pedrolpena/datapod/schematics/datapod/datapod_front.png

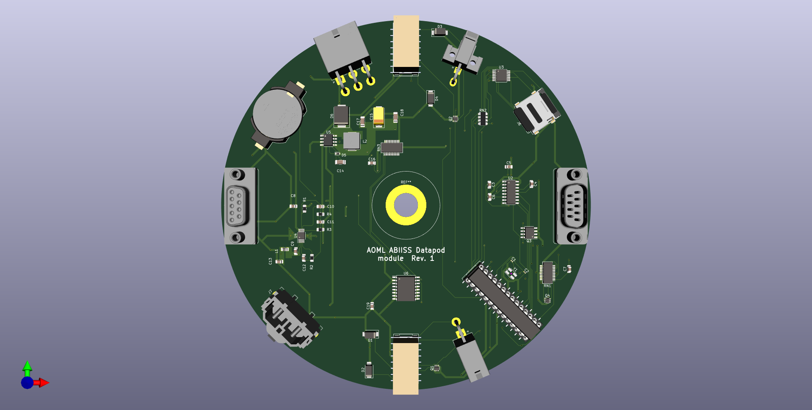
schematics/datapod/datapod_front.png
