pedrolpena/datapod/schematics/datapod/datapod.png

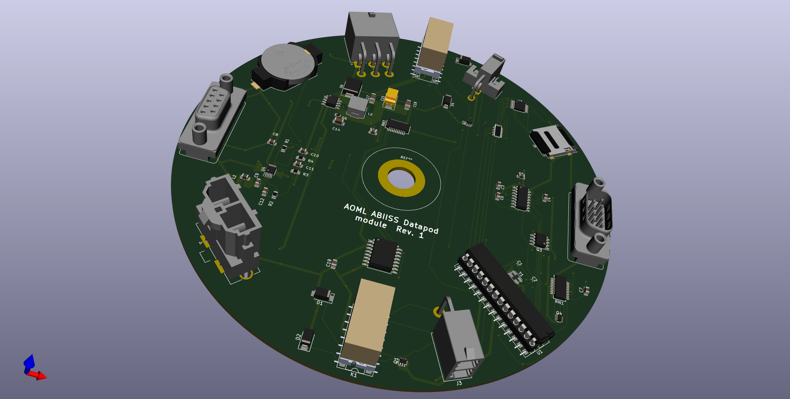
schematics/datapod/datapod.png
