pedrolpena/datapod/schematics/a3la_db25_to_db9/3d_models/db9-male-horizontal.stp

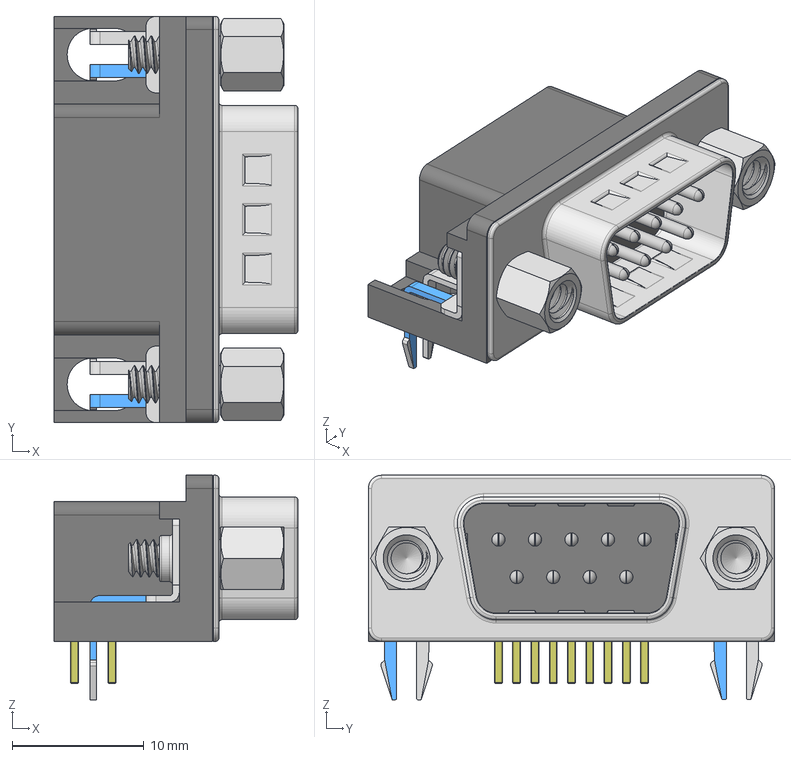
[picture p3: CAD file, 2020-01-16]
schematics/a3la_db25_to_db9/3d_models/db9-male-horizontal.stp
18.5 x 30.8 x 17.0 mm
Тело разъема
Лицевая панель
D-TPIN0 x 9
DIP D-Sub x 2
11,8 х внутренняя резьба x 2
PCB-pin x 5
PCB-pin-7.94 x 4
