pedrolpena/datapod/schematics/a3la_db25_to_db9/3d_models/D-Sub6180xx211821_female.stp

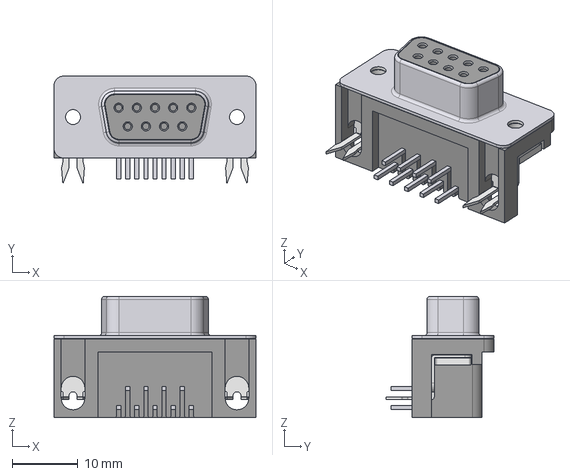
[picture p4: CAD file, 2020-01-16]
schematics/a3la_db25_to_db9/3d_models/D-Sub6180xx211821_female.stp
30.8 x 16.5 x 18.5 mm
