pedrolpena/datapod/schematics/a3la_db25_to_db9/3d_models/Crystal ABM3-16.000MHZ-B2-T.stp

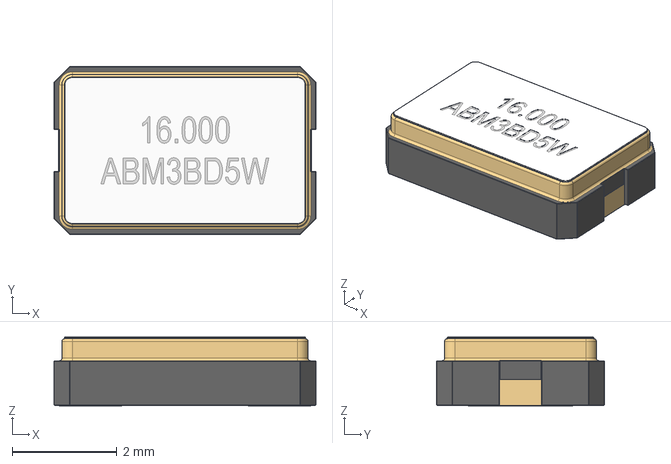
[picture p5: CAD file, 2019-11-07]
schematics/a3la_db25_to_db9/3d_models/Crystal ABM3-16.000MHZ-B2-T.stp
5.00 x 3.20 x 1.31 mm
