pedrolpena/datapod/schematics/a3la_db25_to_db9/3d_models/CR2032-50004LC.stp

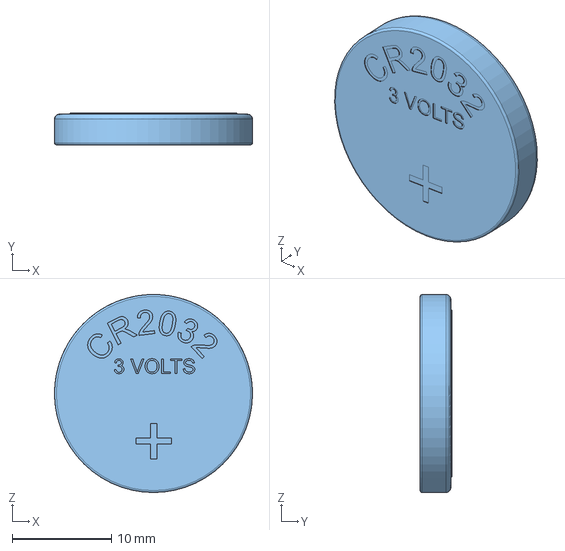
[picture p6: CAD file, 2019-11-07]
schematics/a3la_db25_to_db9/3d_models/CR2032-50004LC.stp
20.0 x 3.20 x 20.0 mm
