pedrolpena/datapod/schematics/a3la_db25_to_db9/3d_models/uSD_card.STEP

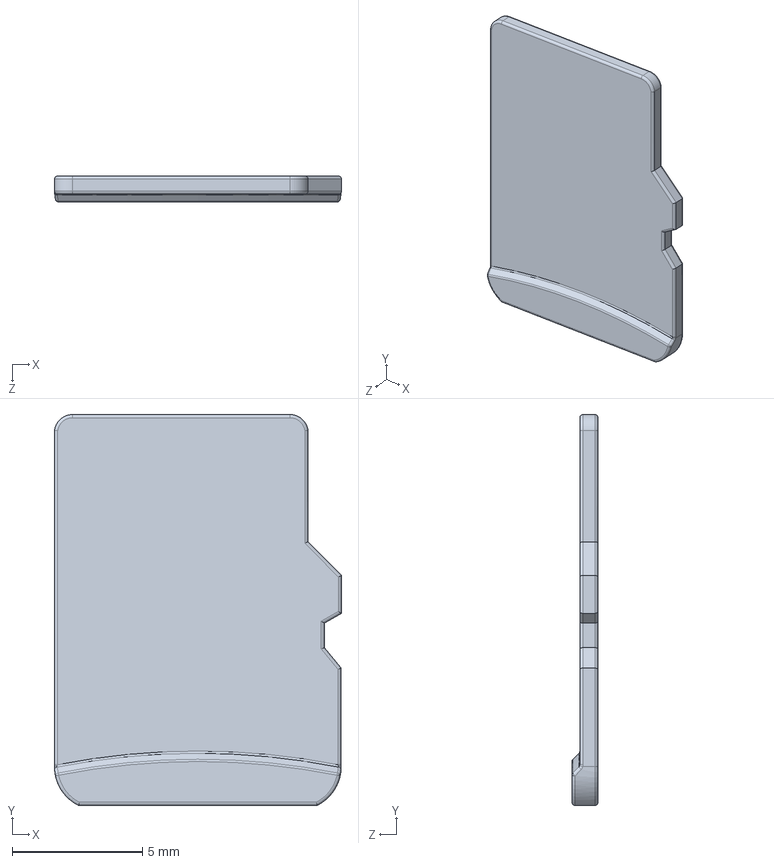
[picture p7: CAD file, 2019-11-07]
schematics/a3la_db25_to_db9/3d_models/uSD_card.STEP
11.0 x 15.0 x 1.00 mm
