pedrolpena/datapod/schematics/a3la_db25_to_db9/3d_models/LD09S24A4GV00LF.stp

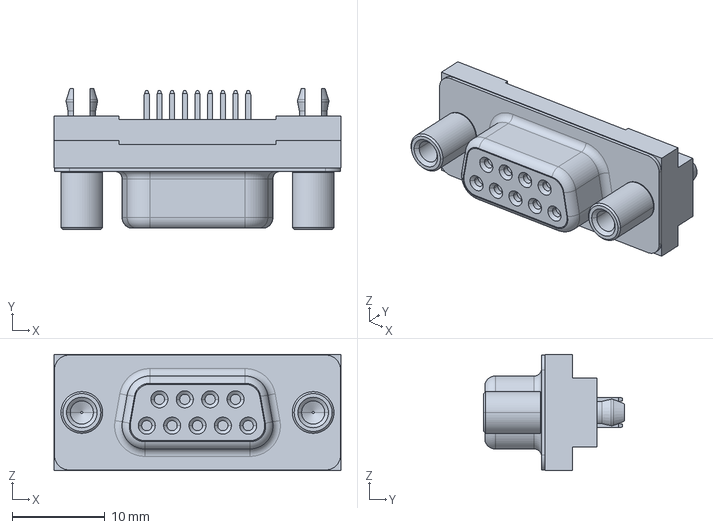
[picture p8: CAD file, 2019-11-06]
schematics/a3la_db25_to_db9/3d_models/LD09S24A4GV00LF.stp
31.0 x 15.2 x 12.6 mm
