pedrolpena/datapod/schematics/a3la_db25_to_db9/3d_models/RELAY_DS2E_L2.step

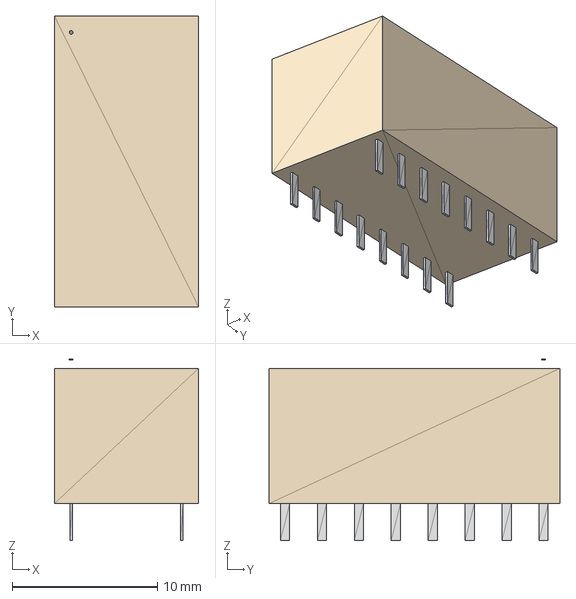
[picture p9: CAD file, 2019-11-06]
schematics/a3la_db25_to_db9/3d_models/RELAY_DS2E_L2.step
9.91 x 20.0 x 12.4 mm
