pedrolpena/datapod/schematics/a3la_db25_to_db9/3d_models/110-xx-328-41-105000.stp

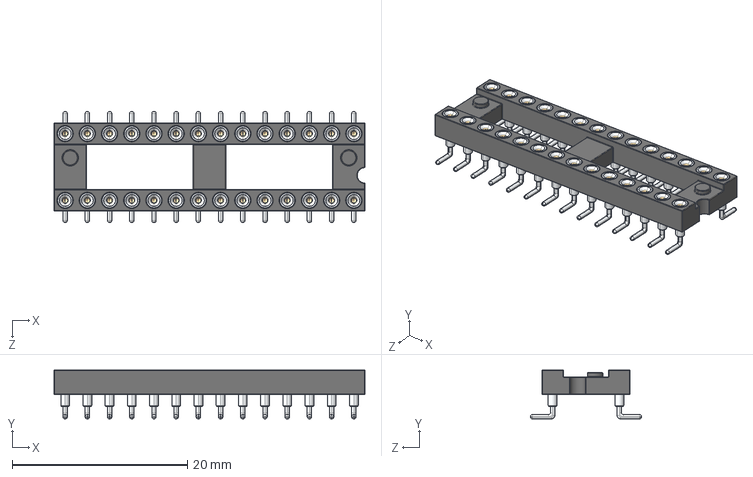
[picture p10: CAD file, 2019-11-06]
schematics/a3la_db25_to_db9/3d_models/110-xx-328-41-105000.stp
35.5 x 5.59 x 12.7 mm
110-xx-328-41-001000
Right-Angle-Pin-SN x 28
