pedrolpena/datapod/schematics/a3la_db25_to_db9/3d_models/SRP6540.stp

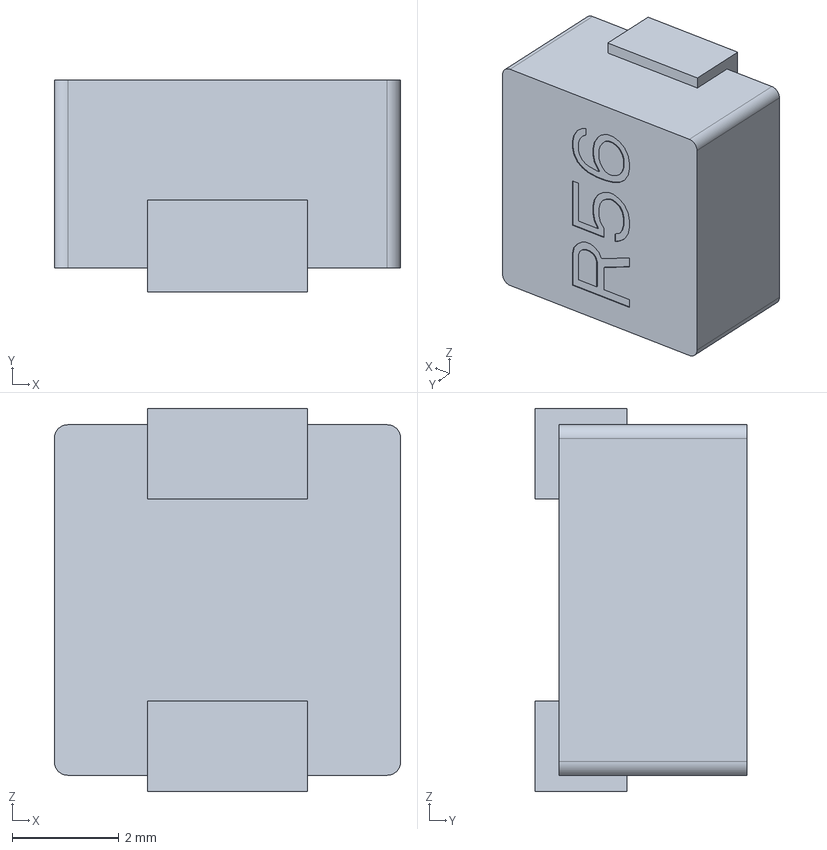
[picture p12: CAD file, 2019-11-06]
schematics/a3la_db25_to_db9/3d_models/SRP6540.stp
6.50 x 3.99 x 7.19 mm
