pedrolpena/datapod/schematics/a3la_db25_to_db9/3d_models/428202213.stp

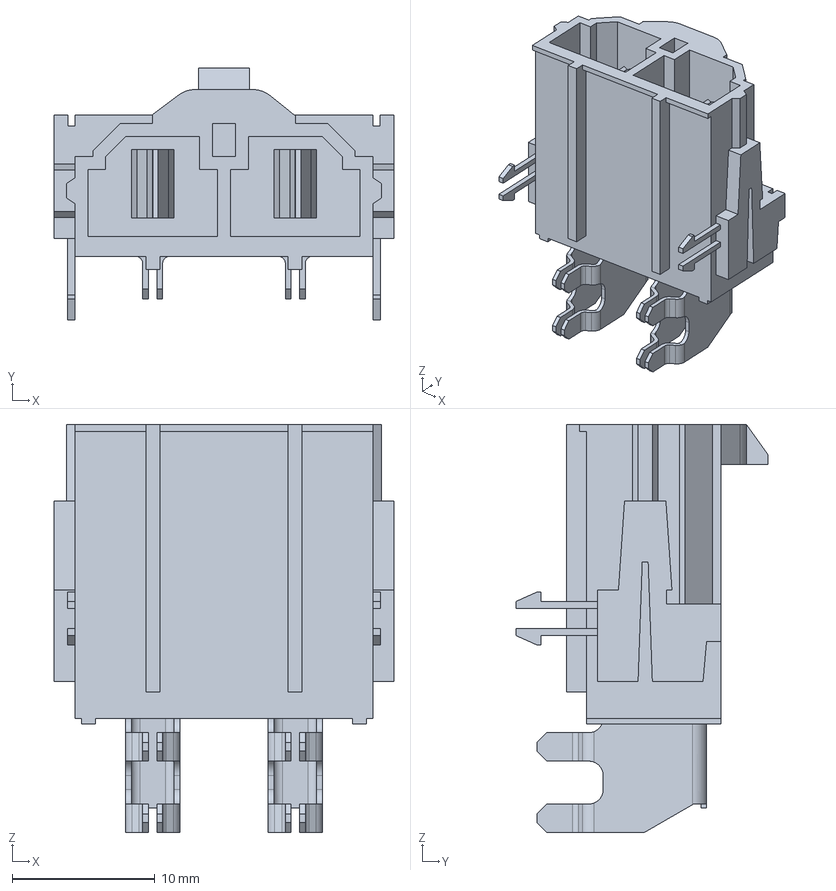
[picture p13: CAD file, 2020-01-16]
schematics/a3la_db25_to_db9/3d_models/428202213.stp
23.8 x 17.6 x 28.6 mm
