pedrolpena/datapod/schematics/a3la_db25_to_db9/3d_models/1053091302.stp

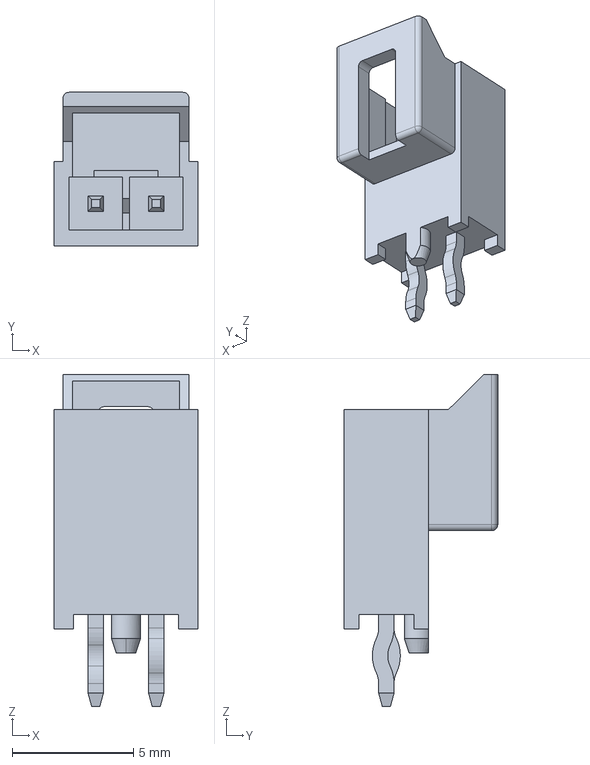
[picture p14: CAD file, 2019-11-18]
schematics/a3la_db25_to_db9/3d_models/1053091302.stp
5.94 x 6.34 x 13.7 mm
