pedrolpena/datapod/schematics/a3la_db25_to_db9/3d_models/039291028.stp

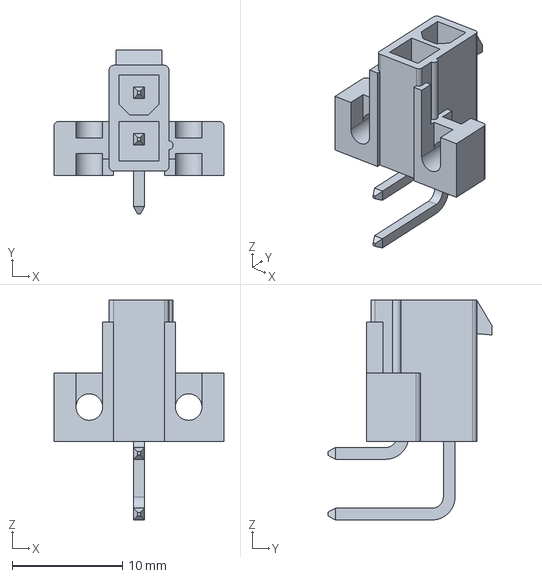
[picture p15: CAD file, 2019-11-06]
schematics/a3la_db25_to_db9/3d_models/039291028.stp
15.4 x 14.9 x 19.9 mm
