pedrolpena/datapod/schematics/a3la_db25_to_db9/3d_models/768250002.stp

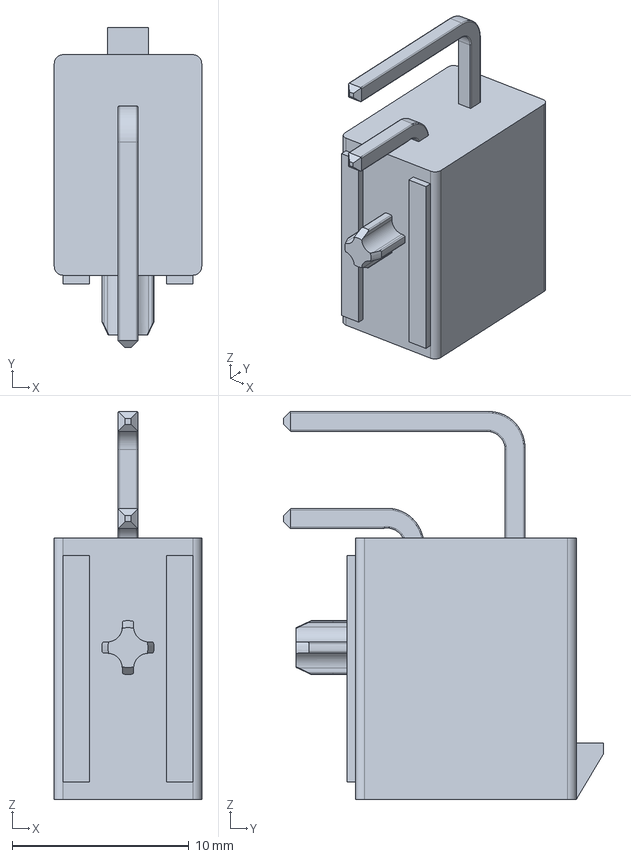
[picture p16: CAD file, 2019-11-06]
schematics/a3la_db25_to_db9/3d_models/768250002.stp
8.35 x 18.1 x 22.0 mm
