pedrolpena/datapod/schematics/a3la_db25_to_db9/3d_models/428192214.stp

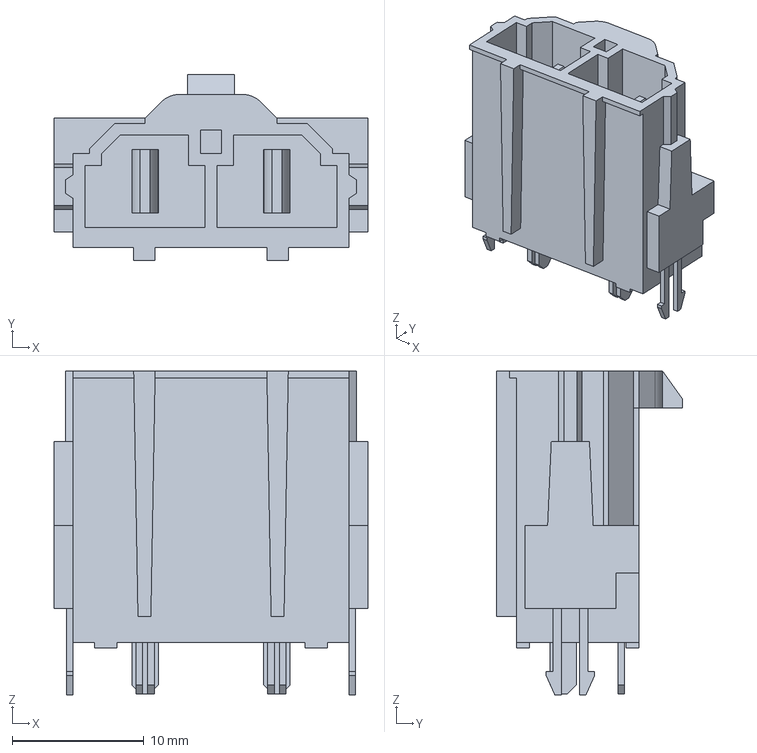
[picture p17: CAD file, 2019-11-06]
schematics/a3la_db25_to_db9/3d_models/428192214.stp
23.8 x 14.1 x 24.6 mm
