pedrolpena/datapod/schematics/a3la_db25_to_db9/3d_models/768250006.stp

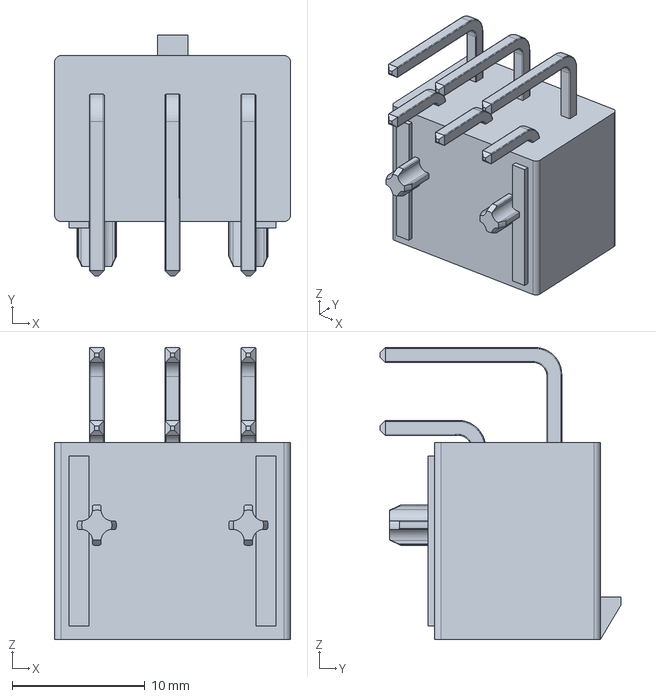
[picture p18: CAD file, 2019-11-06]
schematics/a3la_db25_to_db9/3d_models/768250006.stp
17.8 x 18.1 x 22.0 mm
