pedrolpena/datapod/schematics/a3la_db25_to_db9/3d_models/693072010801.stp

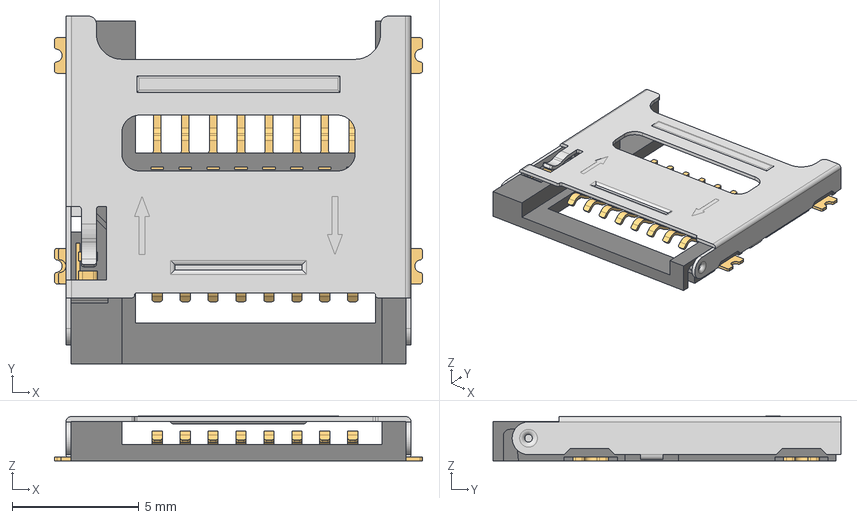
[picture p19: CAD file, 2019-11-06]
schematics/a3la_db25_to_db9/3d_models/693072010801.stp
14.5 x 13.7 x 1.77 mm
693072010801_PIN x 8
693072010801_PATTE x 4
693072010801_CACHE
693072010801_PATTE_SPE
