pedrolpena/datapod/(list of files, cad)

Other CAD files:
schematics/a3la_db25_to_db9/3d_models/LD09P24A4GV00LF .stp
