pedrolpena/datapod/(list of files, drawings)

Other design files:
schematics/datapod/datapod.dsn
schematics/datapod/datapod_last.dsn
