pedrolpena/datapod/schematics/a3la_db25_to_db9/a3la_db25_to_db9.kicad_pcb

## KiCad design schematics/a3la_db25_to_db9/a3la_db25_to_db9.kicad_pcb (2020-02-13)

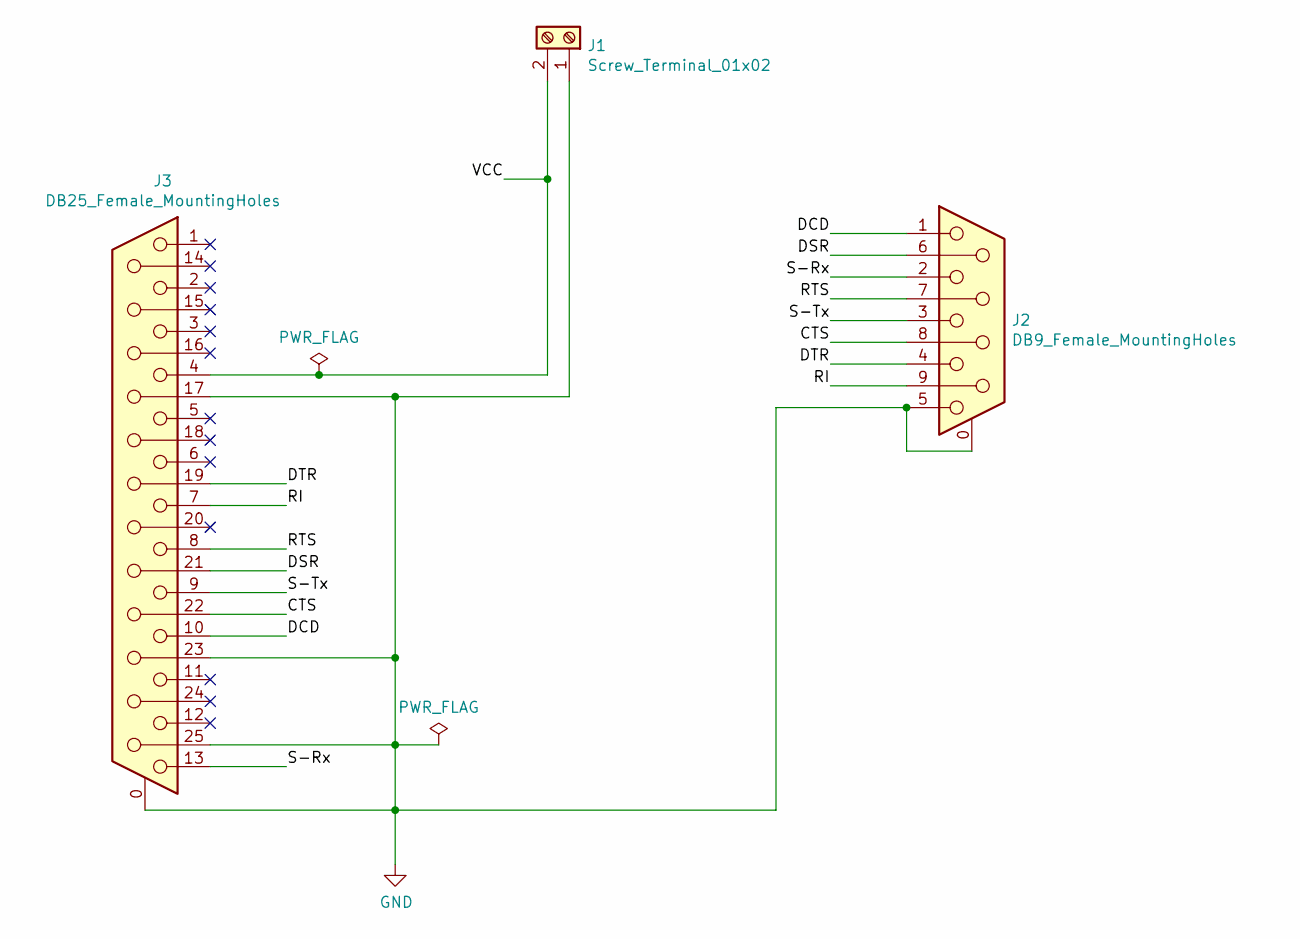
[picture p20: schematic a3la_db25_to_db9.sch, DB25 to DB9 adapter for the NAL A3LA modems]

Parts:
J1: Screw_Terminal_01x02; TerminalBlock_Phoenix_PT-1,5-2-5.0-H_1x02_P5.00mm_Horizontal; part# 277-1667-ND
J2: DB9_Female_MountingHoles; DSUB-9_Female_Horizontal_P2.77x2.84mm_EdgePinOffset7.70mm_H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; Part# A32075-ND
J3: DB25_Female_MountingHoles; DSUB-25_Female_Horizontal_P2.77x2.84mm_EdgePinOffset7.70mm_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; Part# A32077-ND

Connections:
/CTS: J2.8, J3.22
/DCD: J2.1, J3.10
/DSR: J2.6, J3.21
/DTR: J2.4, J3.19
/RI: J2.9, J3.7
/RTS: J2.7, J3.8
/S-Rx: J2.2, J3.13
/S-Tx: J2.3, J3.9
/VCC: J1.2, J3.4
GND: J1.1, J2.0 (PAD), J2.5, J3.0 (PAD), J3.17, J3.23, J3.25

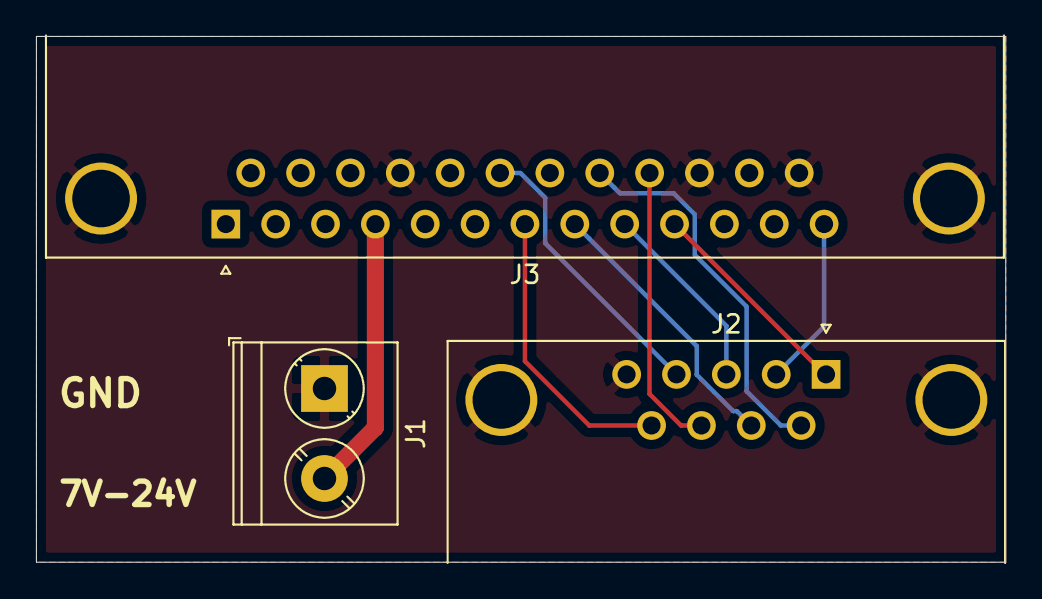
[picture p21: board a3la_db25_to_db9.kicad_pcb from above]

Board: 2 copper layers, 53.8 x 29.2 mm, 3 parts (0 on the bottom side), 10 nets.
