pedrolpena/datapod/schematics/datapod/datapod.kicad_pcb

## KiCad design schematics/datapod/datapod.kicad_pcb (2020-02-05)

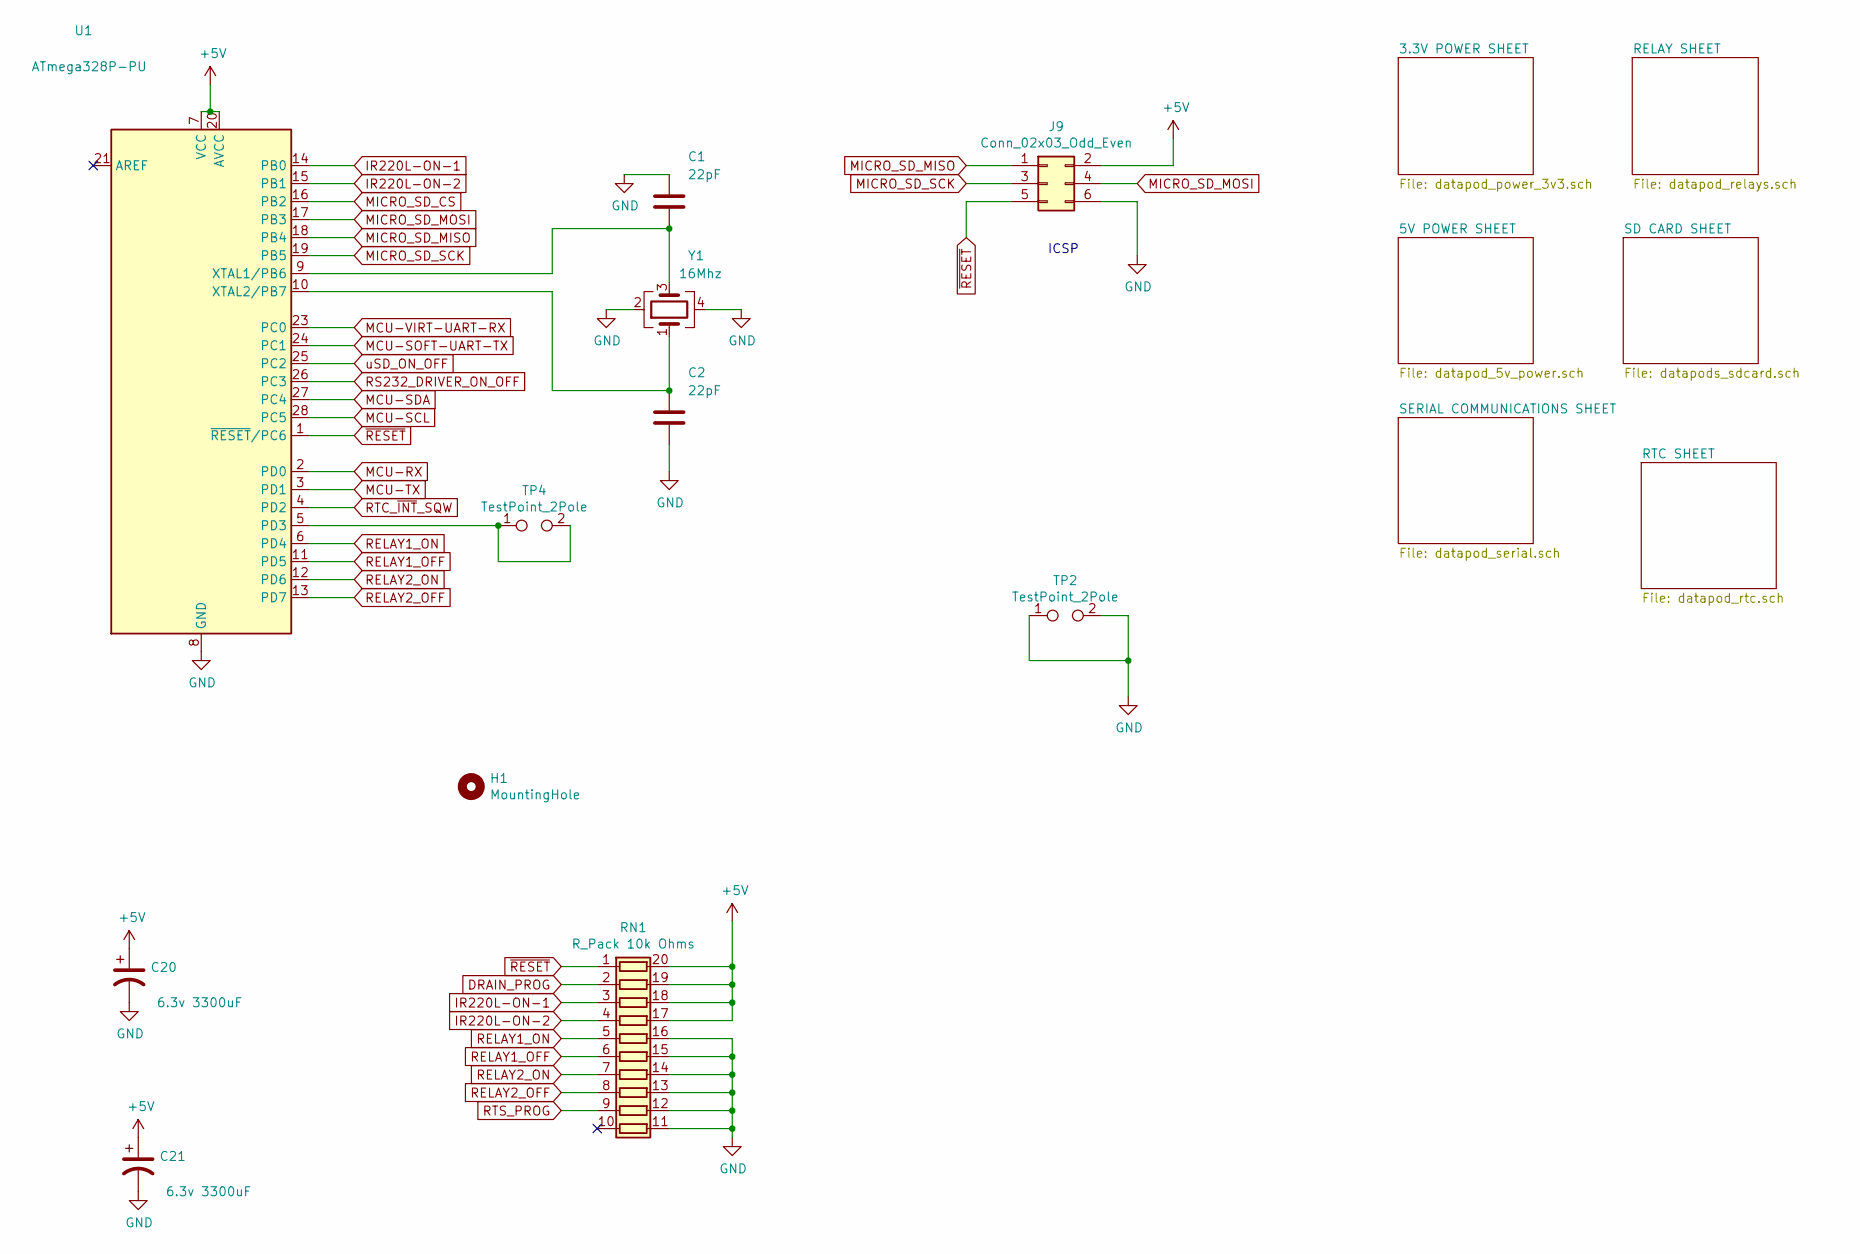
[picture p22: schematic datapod.sch, Datapod data logger and transmitter]

Parts:
C1, C2: 22pF; C_1206_3216Metric_Pad1.42x1.75mm_HandSolder; Part# 399-8165-1-ND
C20, C21: 6.3v 3300uF; CP_Radial_D10.0mm_P5.00mm; Part# 493-1009-ND
H1: MountingHole; MountingHole_0.4_inches_Pad_Via; Part# DNI
J9: Conn_02x03_Odd_Even; PinHeader_2x03_P2.54mm_Vertical_SMD; Part# WM17457-ND
RN1: R_Pack 10k Ohms; SSOP-20_3.9x8.7mm_P0.635mm; Part# OSOPT-10KACT-ND
TP2, TP4: TestPoint_2Pole; TestPoint_2Pads_Pitch5.08mm_Drill1.3mm; Part# DNI
U1: ATmega328P-PU; DIP-28_W7.62mm_SMDSocket_SmallPads; Part# 110-47-328-41-105000
Y1: 16Mhz; Oscillator_SMD_EuroQuartz_XO32-4Pin_3.2x2.5mm_HandSoldering; Part# 732-FA-23816B-C

Connections:
+5V: C20.1, C21.1, J9.2, RN1.17 (R4.2), RN1.18 (R3.2), RN1.19 (R2.2), RN1.20 (R1.2), U1.7 (VCC), U1.20 (AVCC); also elsewhere on the board
DRAIN_PROG: RN1.2 (R2.1); also elsewhere on the board
GND: C1.1, C2.2, C20.2, C21.2, J9.6, RN1.11 (R10.2), RN1.12 (R9.2), RN1.13 (R8.2), RN1.14 (R7.2), RN1.15 (R6.2), RN1.16 (R5.2), TP2.1, TP2.2, U1.8 (GND), U1.22 (GND), Y1.2, Y1.4; also elsewhere on the board
IR220L-ON-1: RN1.3 (R3.1), U1.14 (PB0); also elsewhere on the board
IR220L-ON-2: RN1.4 (R4.1), U1.15 (PB1); also elsewhere on the board
MCU-RX: U1.2 (PD0); also elsewhere on the board
MCU-SCL: U1.28 (PC5); also elsewhere on the board
MCU-SDA: U1.27 (PC4); also elsewhere on the board
MCU-SOFT-UART-TX: U1.24 (PC1); also elsewhere on the board
MCU-TX: U1.3 (PD1); also elsewhere on the board
MCU-VIRT-UART-RX: U1.23 (PC0); also elsewhere on the board
MICRO_SD_CS: U1.16 (PB2); also elsewhere on the board
MICRO_SD_MISO: J9.1, U1.18 (PB4); also elsewhere on the board
MICRO_SD_MOSI: J9.4, U1.17 (PB3); also elsewhere on the board
MICRO_SD_SCK: J9.3, U1.19 (PB5); also elsewhere on the board
unnamed: C1.2, U1.9 (XTAL1/PB6), Y1.3
unnamed: C2.1, U1.10 (XTAL2/PB7), Y1.1
unnamed: TP4.1, TP4.2, U1.5 (PD3)
RELAY1_OFF: RN1.6 (R6.1), U1.11 (PD5); also elsewhere on the board
RELAY1_ON: RN1.5 (R5.1), U1.6 (PD4); also elsewhere on the board
RELAY2_OFF: RN1.8 (R8.1), U1.13 (PD7); also elsewhere on the board
RELAY2_ON: RN1.7 (R7.1), U1.12 (PD6); also elsewhere on the board
RS232_DRIVER_ON_OFF: U1.26 (PC3); also elsewhere on the board
RTC_~INT~_SQW: U1.4 (PD2); also elsewhere on the board
RTS_PROG: RN1.9 (R9.1); also elsewhere on the board
uSD_ON_OFF: U1.25 (PC2); also elsewhere on the board
~RESET: J9.5, RN1.1 (R1.1), U1.1 (~RESET~/PC6); also elsewhere on the board

Notes on the sheet:
ICSP

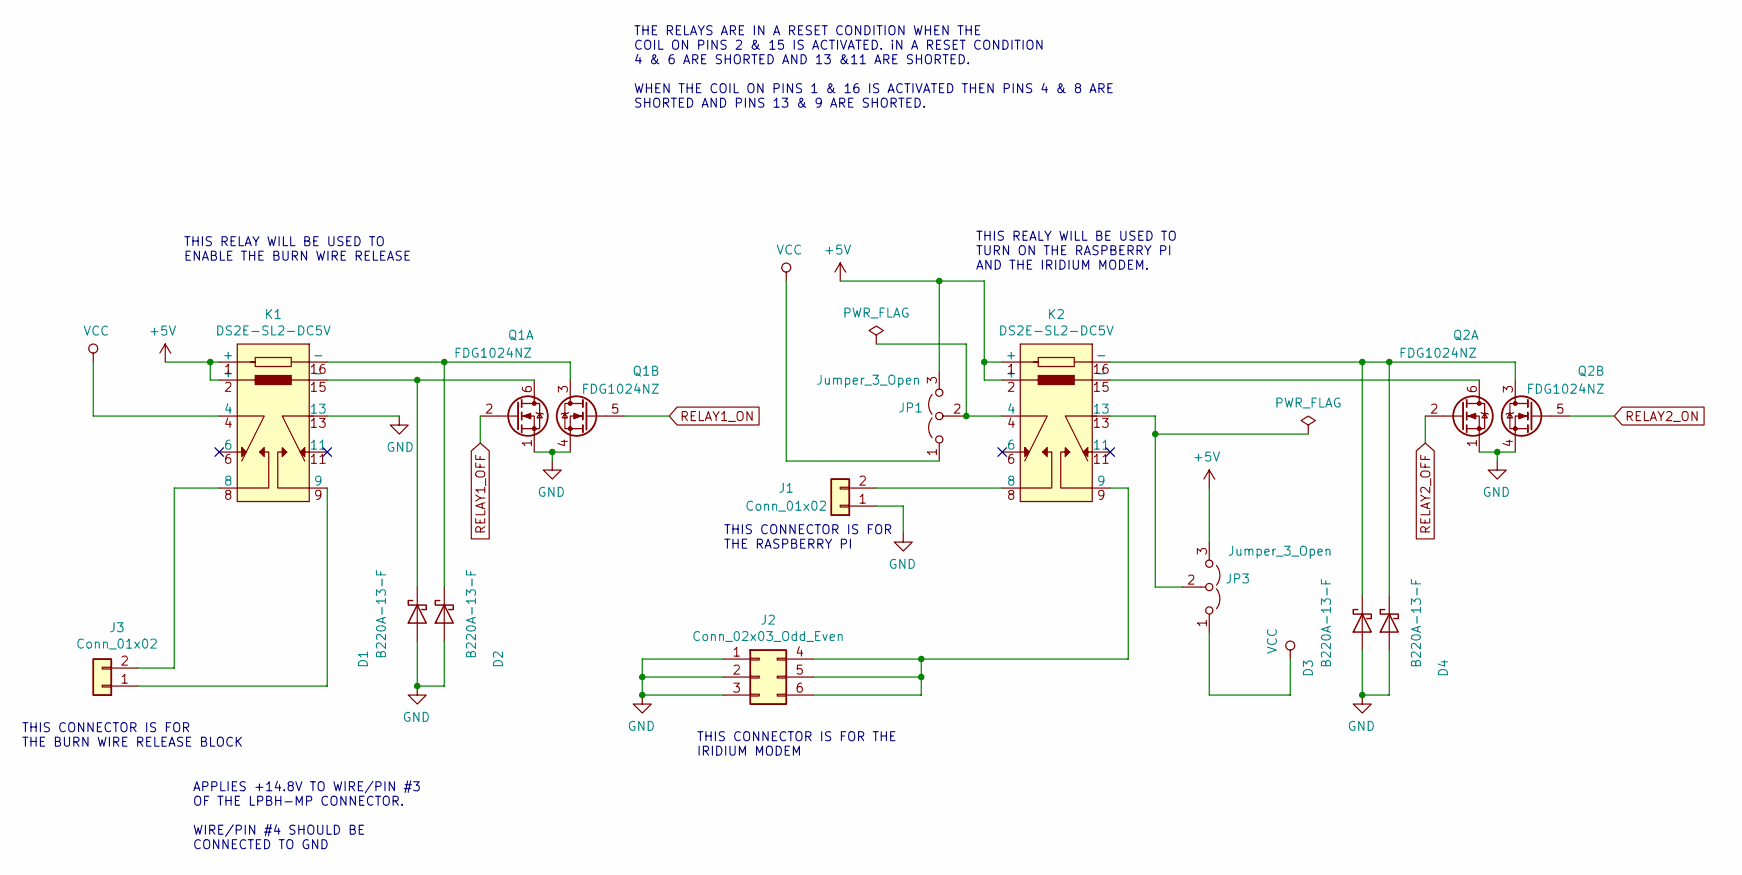
[picture p23: schematic datapod_relays.sch, Relays]

Parts:
D1, D2, D3, D4: B220A-13-F; D_SMA; Part# B220A-FDIDKR-ND
J1: Conn_01x02; Molex_Mini-Fit_Jr_5569-02A1_2x01_P4.20mm_Horizontal; Part# WM3900-ND
J2: Conn_02x03_Odd_Even; Molex_Mega-Fit_76825-0006_2x03_P5.70mm_Horizontal; Part# WM11971-ND
J3: Conn_01x02; Molex_Mega-Fit_76825-0002_2x01_P5.70mm_Horizontal; Part# WM11969-ND
JP1, JP3: Jumper_3_Open; SolderJumper-3_P1.3mm_Open_RoundedPad1.0x1.5mm; Part# DNI
K1, K2: DS2E-SL2-DC5V; DIP-16_W8.89mm_SMDSocket_LongPads; Part# ED11086-ND
Q1, Q2: FDG1024NZ; SOT-363_SC-70-6; Part# FDG1024NZFSCT-ND

Connections:
+5V: JP1.3 (B), JP3.3 (B), K1.1 (+), K1.2 (+), K2.1 (+), K2.2 (+); also elsewhere on the board
GND: D1.2 (A), D2.2 (A), D3.2 (A), D4.2 (A), J1.1, J2.1, J2.2, J2.3, K1.13, Q1.1 (S), Q1.4 (S), Q2.1 (S), Q2.4 (S); also elsewhere on the board
unnamed: D1.1 (K), K1.15 (-), Q1.6 (D)
unnamed: D2.1 (K), K1.16 (-), Q1.3 (D)
unnamed: D3.1 (K), D4.1 (K), K2.16 (-), Q2.3 (D)
unnamed: J1.2, K2.8
unnamed: J2.4, J2.5, J2.6, K2.9
unnamed: J3.1, K1.9
unnamed: J3.2, K1.8
unnamed: JP1.2 (C), K2.4
unnamed: JP3.2 (C), K2.13
unnamed: K2.15 (-), Q2.6 (D)
RELAY1_OFF: Q1.2 (G); also elsewhere on the board
RELAY1_ON: Q1.5 (G); also elsewhere on the board
RELAY2_OFF: Q2.2 (G); also elsewhere on the board
RELAY2_ON: Q2.5 (G); also elsewhere on the board
VCC: JP1.1 (A), JP3.1 (A), K1.4; also elsewhere on the board

Notes on the sheet:
THE RELAYS ARE IN A RESET CONDITION WHEN THE COIL ON PINS 2 & 15 IS ACTIVATED. iN A RESET CONDITION 4 & 6 ARE SHORTED AND 13 &11 ARE SHORTED. WHEN THE COIL ON PINS 1 & 16 IS ACTIVATED THEN PINS 4 & 8 ARE SHORTED AND PINS 13 & 9 ARE SHORTED.
THIS RELAY WILL BE USED TO ENABLE THE BURN WIRE RELEASE
THIS REALY WILL BE USED TO TURN ON THE RASPBERRY PI AND THE IRIDIUM MODEM.
APPLIES +14.8V TO WIRE/PIN #3 OF THE LPBH-MP CONNECTOR. WIRE/PIN #4 SHOULD BE CONNECTED TO GND
THIS CONNECTOR IS FOR THE IRIDIUM MODEM
THIS CONNECTOR IS FOR THE BURN WIRE RELEASE BLOCK
THIS CONNECTOR IS FOR THE RASPBERRY PI

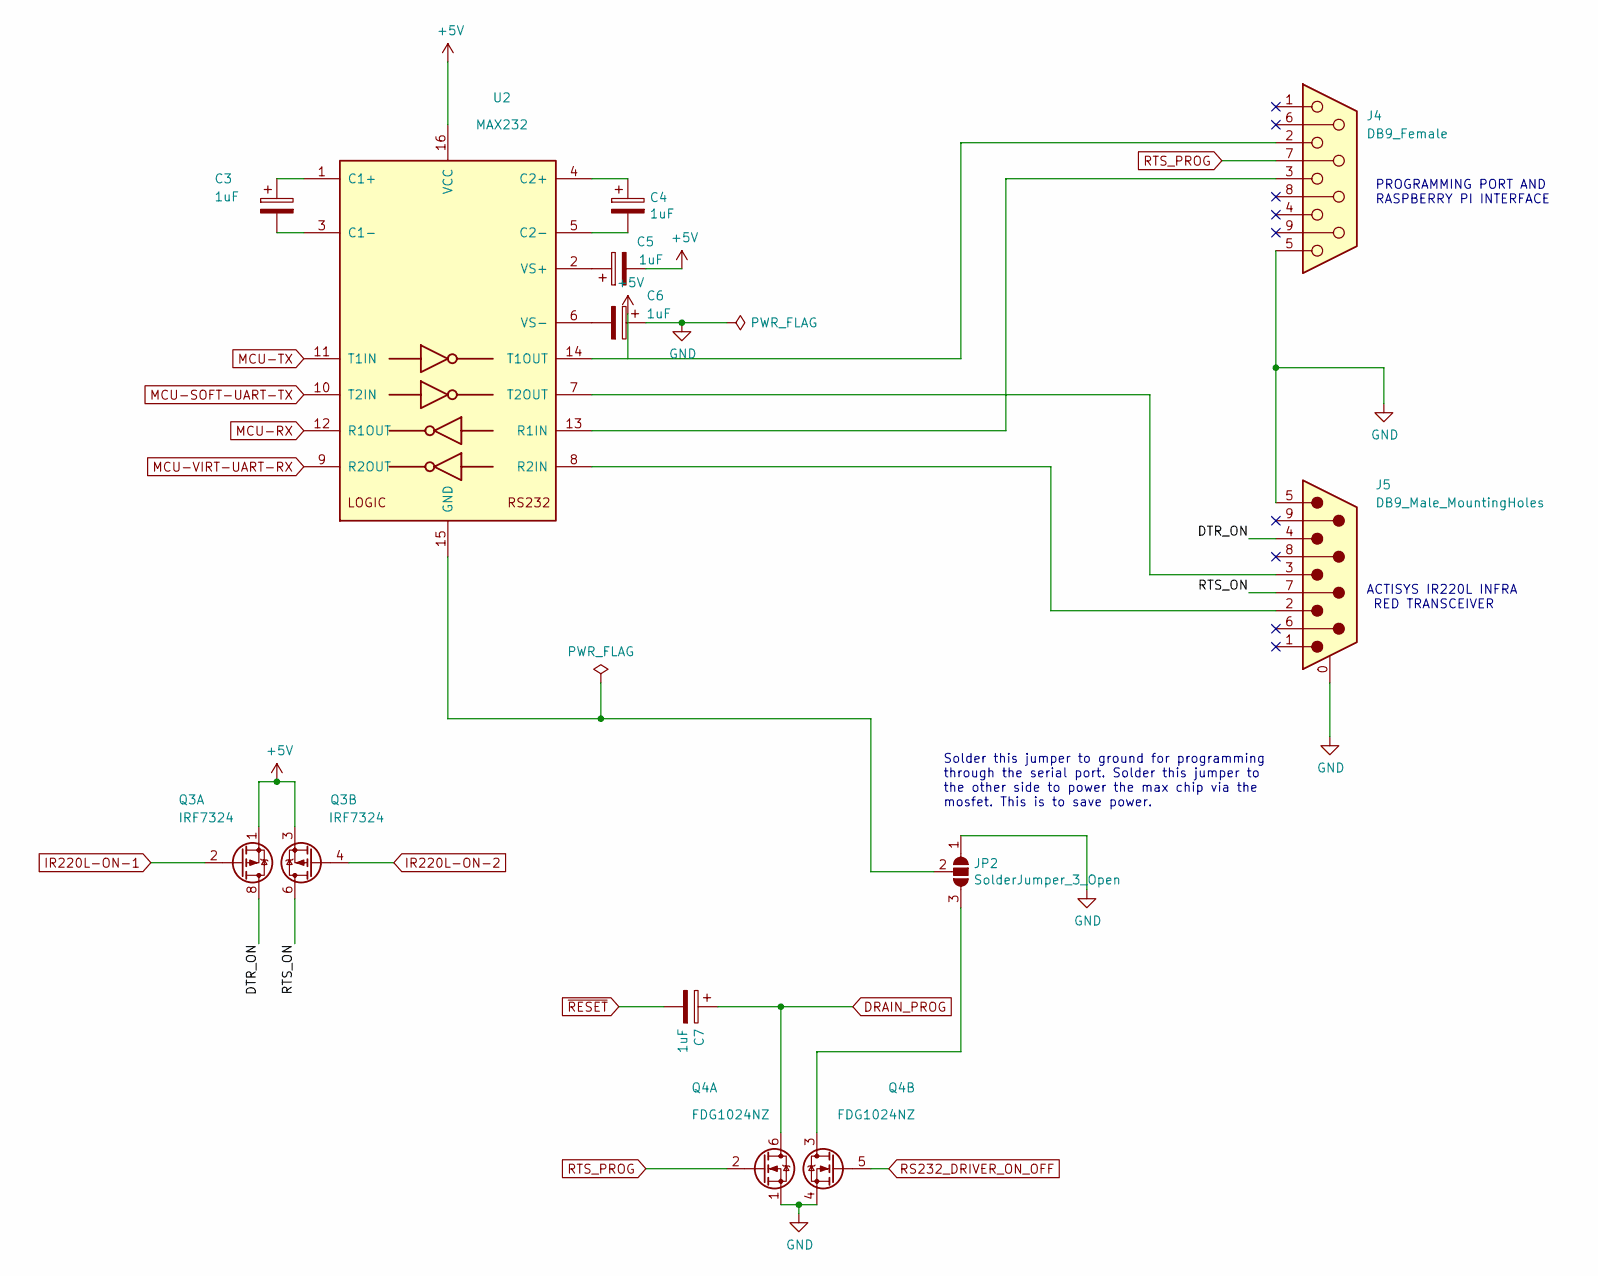
[picture p24: schematic datapod_serial.sch, RS232 Communication]

Parts:
C3, C4, C5, C6, C7: 1uF; C_0805_2012Metric_Pad1.15x1.40mm_HandSolder; Part# TCJP105M025R0500
J4: DB9_Female; DSUB-9_Female_Horizontal_P2.77x2.84mm_EdgePinOffset7.70mm_H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; Part# AE10921-ND
J5: DB9_Male_MountingHoles; DSUB-9_Male_Horizontal_P2.77x2.84mm_EdgePinOffset7.70mm_Hou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; Part# AE10968-ND
JP2: SolderJumper_3_Open; SolderJumper-3_P1.3mm_Open_RoundedPad1.0x1.5mm; Part# DNI
Q3: IRF7324; SOIC-8_3.9x4.9mm_P1.27mm; Part# IRF7324PBFTR-ND
Q4: FDG1024NZ; SOT-363_SC-70-6; Part# FDG1024NZFSCT-ND
U2: MAX232; SOIC-16_3.9x9.9mm_P1.27mm; Part# 296-14619-1-ND

Connections:
+5V: C5.2, Q3.1 (S1), Q3.3 (S2), U2.16 (VCC); also elsewhere on the board
/SERIAL COMMUNICATIONS SHEET/DTR_ON: J5.4, Q3.7 (D1), Q3.8 (D1)
/SERIAL COMMUNICATIONS SHEET/RTS_ON: J5.7, Q3.5 (D2), Q3.6 (D2)
DRAIN_PROG: C7.1, Q4.6 (D); also elsewhere on the board
GND: C6.1, J4.5, J5.0 (PAD), J5.5, JP2.1 (A), Q4.1 (S), Q4.4 (S); also elsewhere on the board
IR220L-ON-1: Q3.2 (G1); also elsewhere on the board
IR220L-ON-2: Q3.4 (G2); also elsewhere on the board
MCU-RX: U2.12 (R1OUT); also elsewhere on the board
MCU-SOFT-UART-TX: U2.10 (T2IN); also elsewhere on the board
MCU-TX: U2.11 (T1IN); also elsewhere on the board
MCU-VIRT-UART-RX: U2.9 (R2OUT); also elsewhere on the board
unnamed: C3.1, U2.1 (C1+)
unnamed: C3.2, U2.3 (C1-)
unnamed: C4.1, U2.4 (C2+)
unnamed: C4.2, U2.5 (C2-)
unnamed: C5.1, U2.2 (VS+)
unnamed: C6.2, U2.6 (VS-)
unnamed: J4.2, U2.14 (T1OUT)
unnamed: J4.3, U2.13 (R1IN)
unnamed: J5.2, U2.8 (R2IN)
unnamed: J5.3, U2.7 (T2OUT)
unnamed: JP2.2 (C), U2.15 (GND)
unnamed: JP2.3 (B), Q4.3 (D)
RS232_DRIVER_ON_OFF: Q4.5 (G); also elsewhere on the board
RTS_PROG: J4.7, Q4.2 (G); also elsewhere on the board
~RESET: C7.2; also elsewhere on the board

Notes on the sheet:
PROGRAMMING PORT AND RASPBERRY PI INTERFACE
ACTISYS IR220L INFRA RED TRANSCEIVER
Solder this jumper to ground for programming through the serial port. Solder this jumper to the other side to power the max chip via the mosfet. This is to save power.

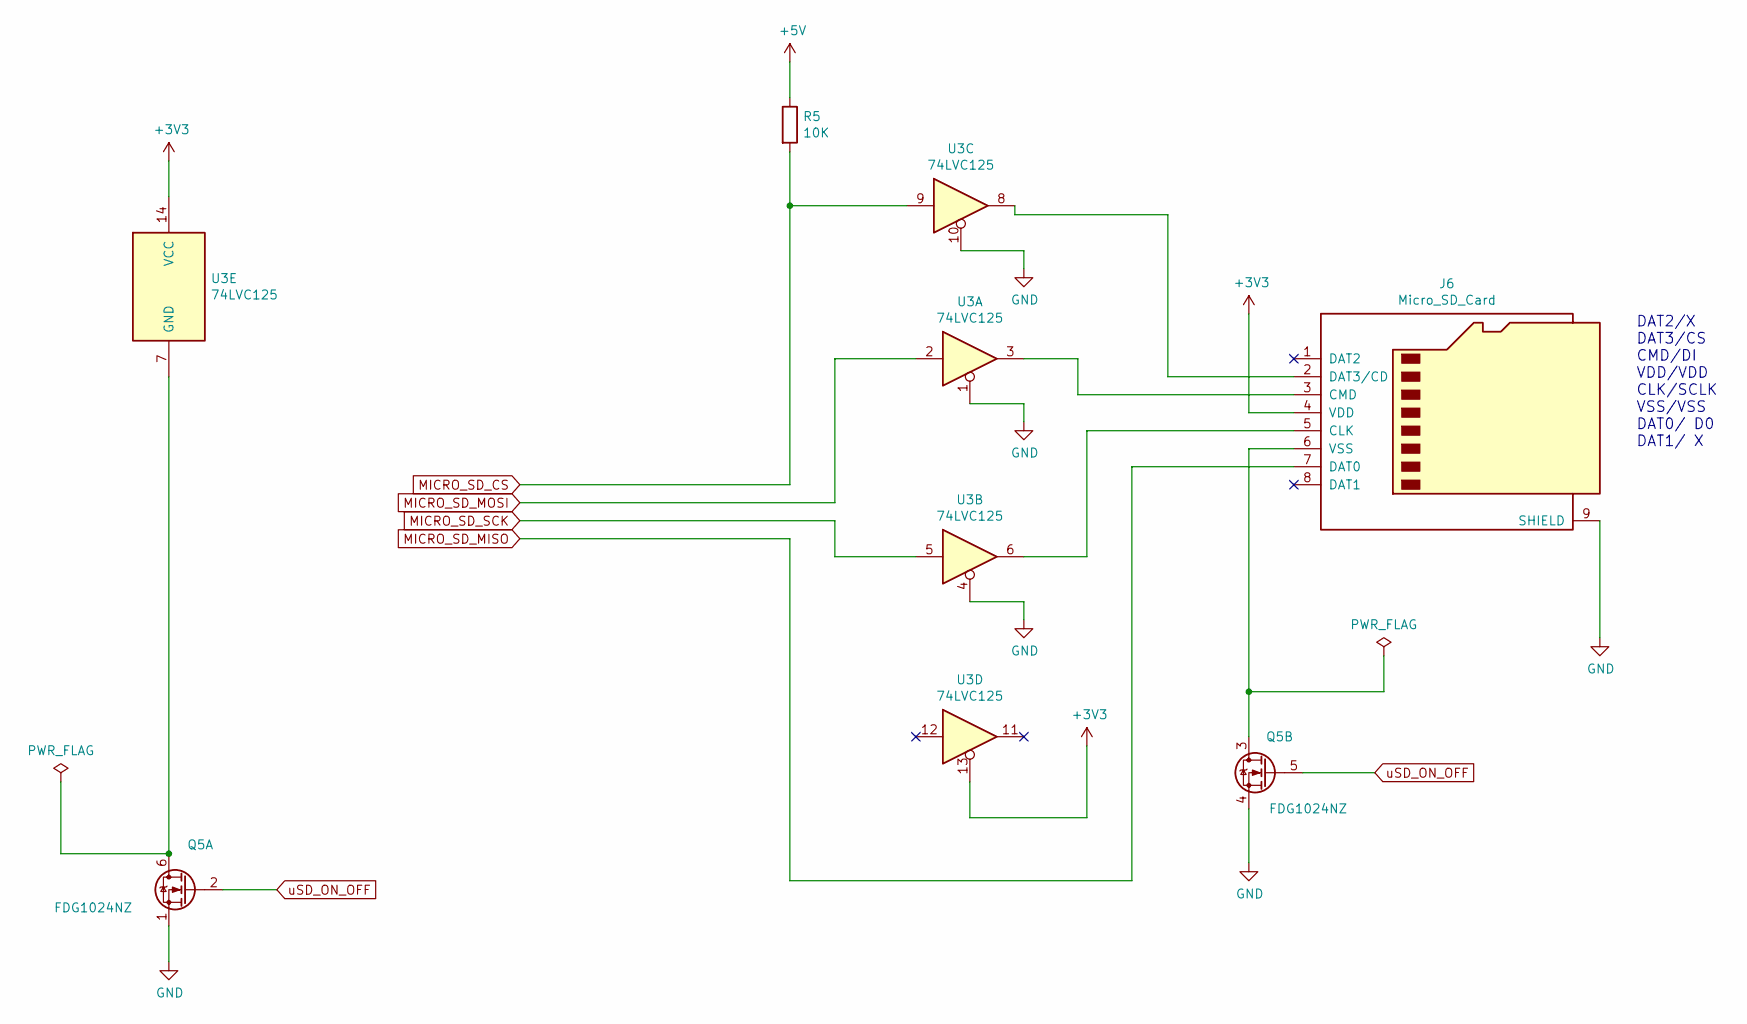
[picture p25: schematic datapods_sdcard.sch, SD Card]

Parts:
J6: Micro_SD_Card; microSD_HC_Wuerth_693072010801; Part# 732-3820-1-ND
Q5: FDG1024NZ; SOT-363_SC-70-6; Part# FDG1024NZFSCT-ND
R5: 10K; R_1206_3216Metric_Pad1.42x1.75mm_HandSolder; Part# 311-10KERCT-ND
U3: 74LVC125; TSSOP-14_4.4x5mm_P0.65mm; Part# 296-1222-1-ND

Connections:
+3V3: J6.4 (VDD), U3.13, U3.14 (VCC); also elsewhere on the board
+5V: R5.1; also elsewhere on the board
GND: J6.9 (SHIELD), Q5.1 (S), Q5.4 (S), U3.1, U3.4, U3.10; also elsewhere on the board
MICRO_SD_CS: R5.2, U3.9; also elsewhere on the board
MICRO_SD_MISO: J6.7 (DAT0); also elsewhere on the board
MICRO_SD_MOSI: U3.2; also elsewhere on the board
MICRO_SD_SCK: U3.5; also elsewhere on the board
unnamed: J6.2 (DAT3/CD), U3.8
unnamed: J6.3 (CMD), U3.3
unnamed: J6.5 (CLK), U3.6
unnamed: J6.6 (VSS), Q5.3 (D)
unnamed: Q5.6 (D), U3.7 (GND)
uSD_ON_OFF: Q5.2 (G), Q5.5 (G); also elsewhere on the board

Notes on the sheet:
DAT2/X DAT3/CS CMD/DI VDD/VDD CLK/SCLK VSS/VSS DAT0/ D0 DAT1/ X

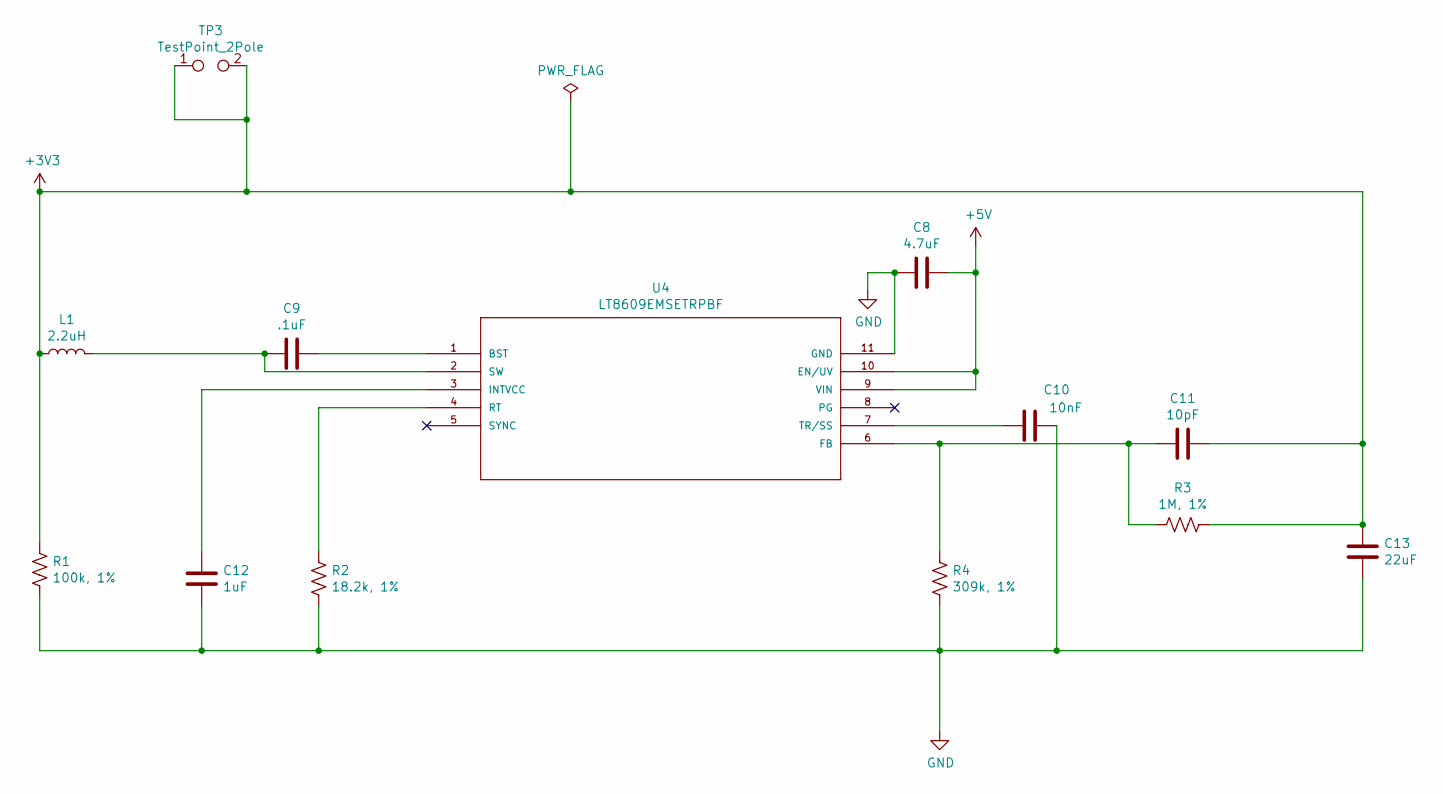
[picture p26: schematic datapod_power_3v3.sch, 3.3V Voltage Circuit]

Parts:
C8: 4.7uF; C_0805_2012Metric_Pad1.15x1.40mm_HandSolder; Part# 490-12753-1-ND
C9: .1uF; C_0805_2012Metric_Pad1.15x1.40mm_HandSolder; Part# 478-3351-1-ND
C10: 10nF; C_0805_2012Metric_Pad1.15x1.40mm_HandSolder; Part# 311-1136-1-ND
C11: 10pF; C_0805_2012Metric_Pad1.15x1.40mm_HandSolder; Part# 399-7062-1-ND
C12: 1uF; C_0805_2012Metric_Pad1.15x1.40mm_HandSolder; Part# 311-1365-1-ND
C13: 22uF; C_0805_2012Metric_Pad1.15x1.40mm_HandSolder; Part# 1276-6780-1-ND
L1: 2.2uH; L_0805_2012Metric_Pad1.15x1.40mm_HandSolder; Part# 587-2771-1-ND
R1: 100k, 1%; R_0805_2012Metric_Pad1.15x1.40mm_HandSolder; Part# 311-100KCRCT-ND
R2: 18.2k, 1%; R_0805_2012Metric_Pad1.15x1.40mm_HandSolder; Part# 311-18.2KCRCT-ND
R3: 1M, 1%; R_0805_2012Metric_Pad1.15x1.40mm_HandSolder; Part# 311-1.00MCRCT-ND
R4: 309k, 1%; R_0805_2012Metric_Pad1.15x1.40mm_HandSolder; Part# 311-309KCRCT-ND
TP3: TestPoint_2Pole; TestPoint_2Pads_Pitch5.08mm_Drill1.3mm; Part# DNI
U4: LT8609EMSETRPBF; MSOP-10-1EP_3x3mm_P0.5mm_EP1.73x1.98mm; Part# LT8609EMSE#TRPBFCT-ND

Connections:
+3V3: C11.2, C13.1, L1.1, R1.1, R3.1, TP3.1, TP3.2; also elsewhere on the board
+5V: C8.1, U4.9 (VIN), U4.10 (EN/UV); also elsewhere on the board
GND: C8.2, C10.1, C12.2, C13.2, R1.2, R2.2, R4.2, U4.11 (GND); also elsewhere on the board
unnamed: C9.1, U4.1 (BST)
unnamed: C9.2, L1.2, U4.2 (SW)
unnamed: C10.2, U4.7 (TR/SS)
unnamed: C11.1, R3.2, R4.1, U4.6 (FB)
unnamed: C12.1, U4.3 (INTVCC)
unnamed: R2.1, U4.4 (RT)

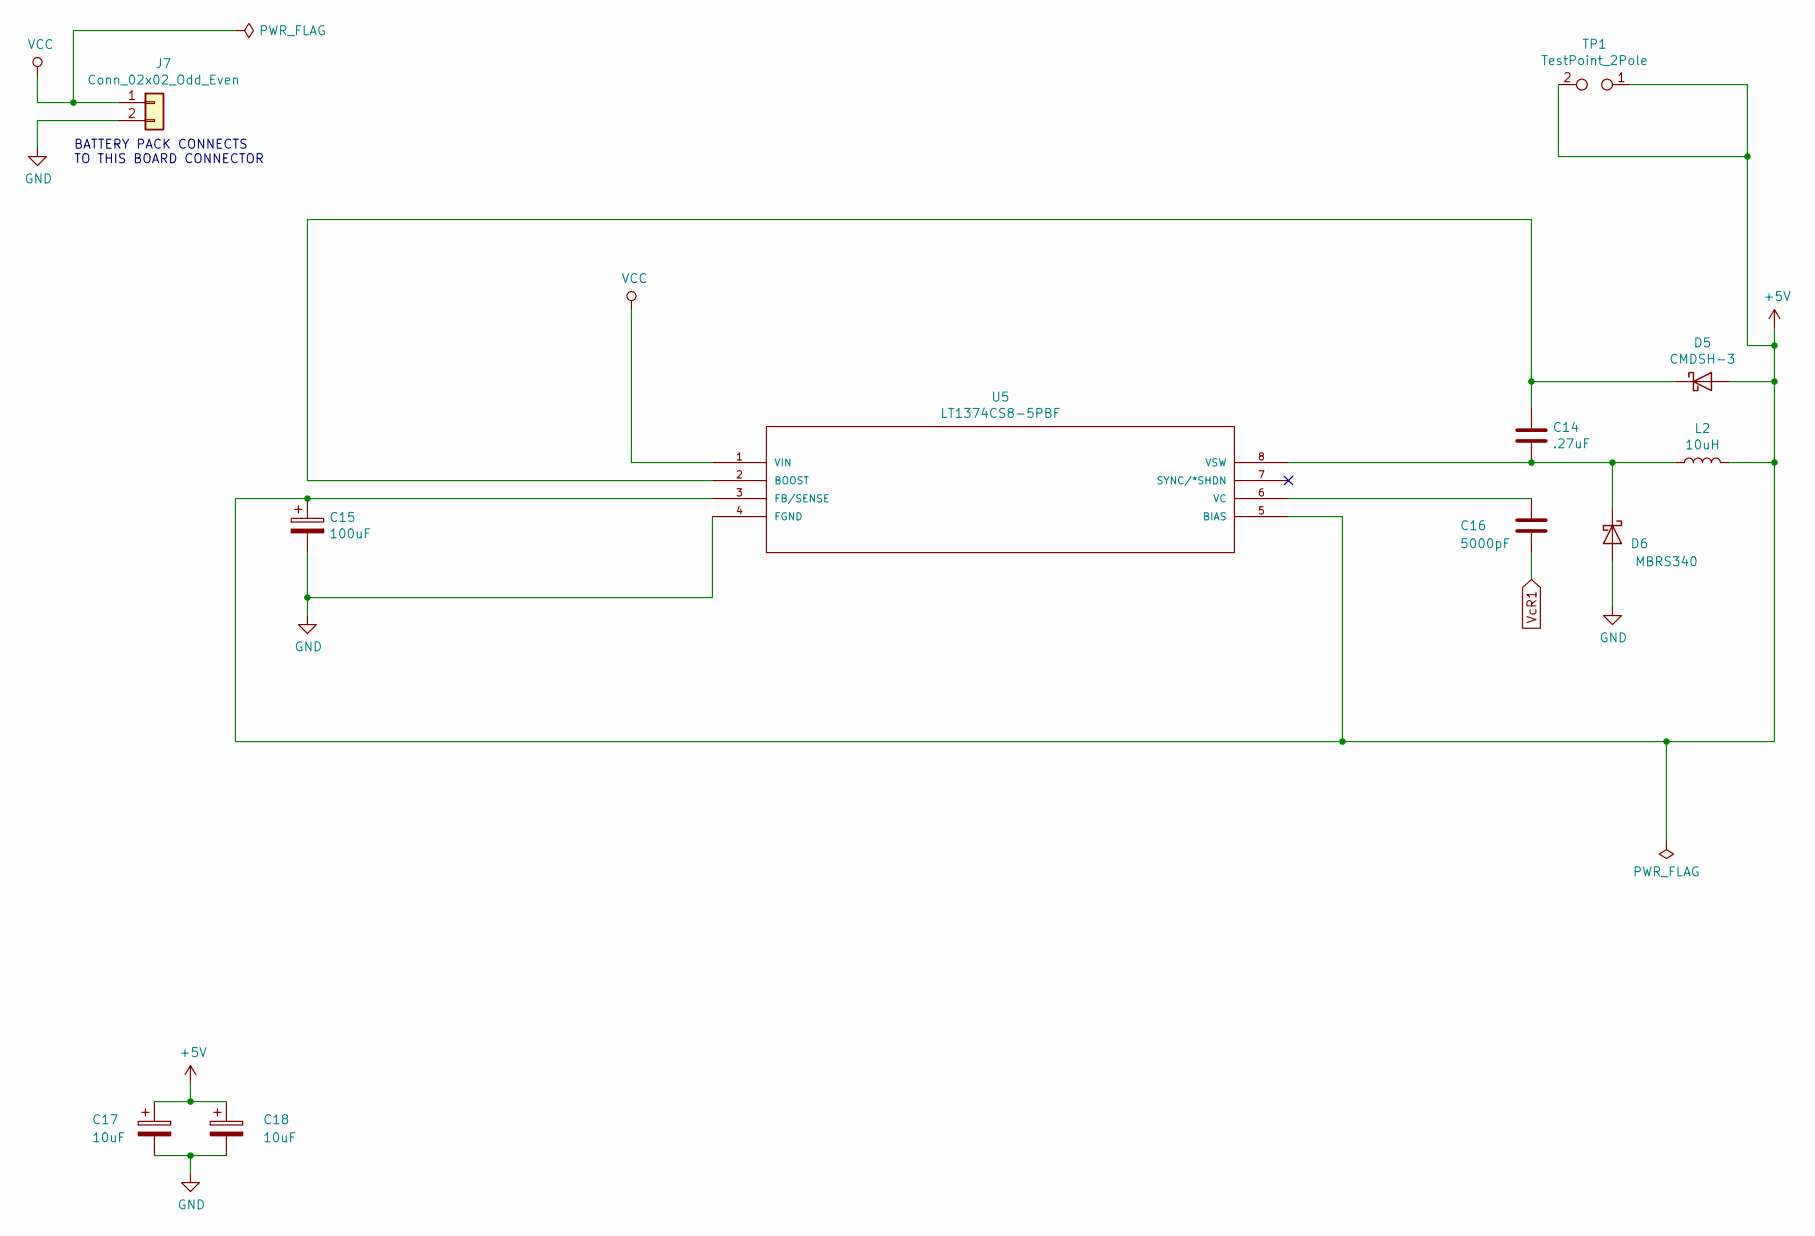
[picture p27: schematic datapod_5v_power.sch, 5V Voltage Circuit]

Parts:
C14: .27uF; C_1206_3216Metric_Pad1.42x1.75mm_HandSolder; Part# 478-1561-1-ND
C15: 100uF; CP_EIA-7343-31_Kemet-D_Pad2.25x2.55mm_HandSolder; Part# 718-1890-1-ND
C16: 5000pF; C_0805_2012Metric_Pad1.15x1.40mm_HandSolder; Part# 478-10560-1-ND
C17, C18: 10uF; C_1206_3216Metric_Pad1.42x1.75mm_HandSolder; Part# TCJA106M025R0150
D5: CMDSH-3; D_SOD-323_HandSoldering; Part# 1514-CMDSH-3TRPBFREECT-ND
D6: MBRS340; D_SMC; Part# MBRS340FSCT-ND
J7: Conn_02x02_Odd_Even; Molex_Nano-Fit_105309-xx02_1x02_P2.50mm_Vertical; Part# WM15036-ND
L2: 10uH; L_Sumida_CDMC6D28_7.25x6.5mm; Part# SRP6540-100MCT-ND
TP1: TestPoint_2Pole; TestPoint_2Pads_Pitch5.08mm_Drill1.3mm; Part# DNI
U5: LT1374CS8-5PBF; SO-8_3.9x4.9mm_P1.27mm; Part# LT1374CS8-5#PBF-ND

Connections:
+5V: C15.1, C17.1, C18.1, D5.2 (A), L2.2, TP1.1, TP1.2, U5.3 (FB/SENSE), U5.5 (BIAS); also elsewhere on the board
GND: C15.2, C17.2, C18.2, D6.2 (A), J7.2, U5.4 (FGND); also elsewhere on the board
unnamed: C14.1, D5.1 (K), U5.2 (BOOST)
unnamed: C14.2, D6.1 (K), L2.1, U5.8 (VSW)
unnamed: C16.1, U5.6 (VC)
VCC: J7.1, U5.1 (VIN); also elsewhere on the board
VcR1: C16.2; also elsewhere on the board

Notes on the sheet:
BATTERY PACK CONNECTS TO THIS BOARD CONNECTOR

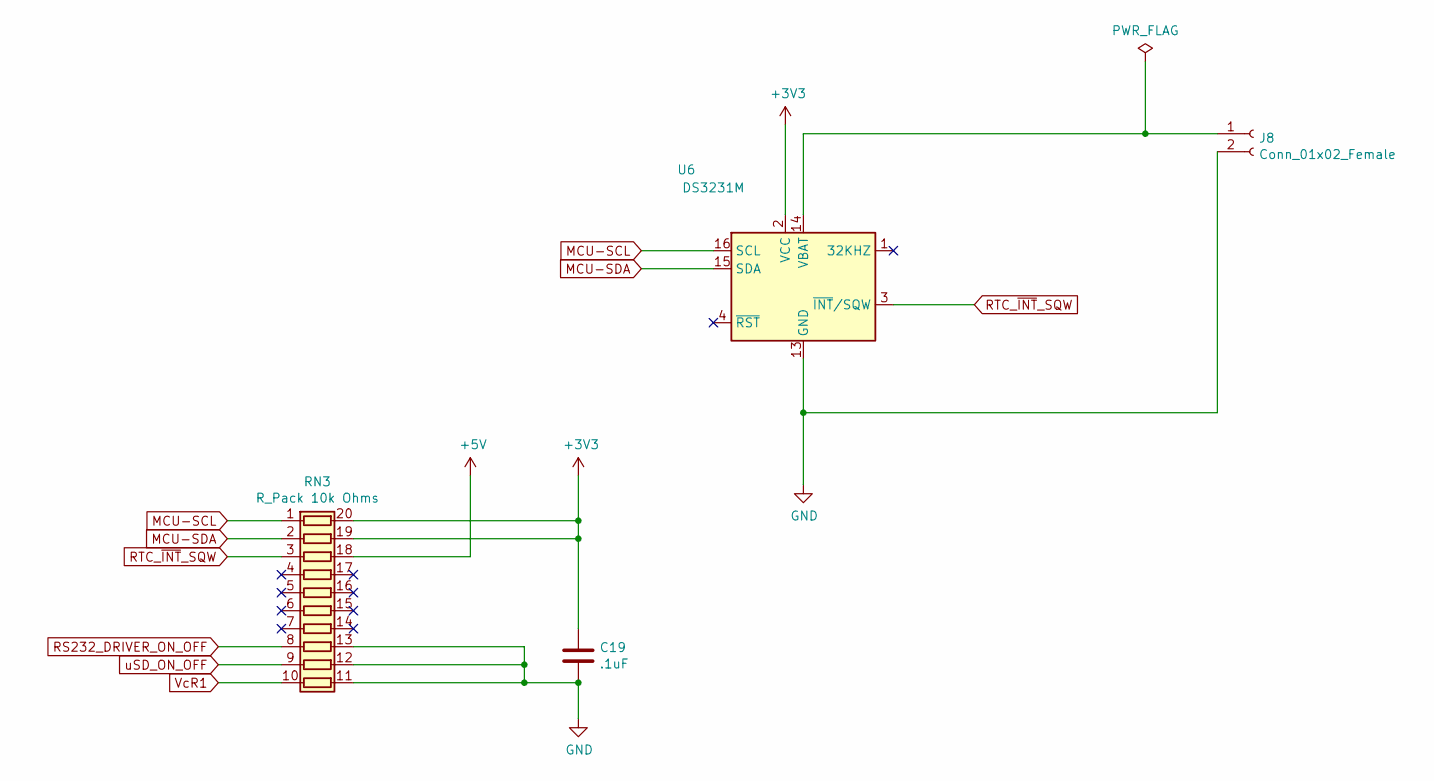
[picture p28: schematic datapod_rtc.sch, Real Time Clock]

Parts:
C19: .1uF; C_0805_2012Metric_Pad1.15x1.40mm_HandSolder; Part# 478-3351-1-ND
J8: Conn_01x02_Female; BatteryHolder_Keystone_1058_1x2032; Part# 36-1058CT-ND
RN3: R_Pack 10k Ohms; SSOP-20_3.9x8.7mm_P0.635mm; Part# OSOPT-10KACT-ND
U6: DS3231M; SOIC-16W_7.5x10.3mm_P1.27mm; Part# DS3231S#T&RCT-ND

Connections:
+3V3: C19.2, RN3.19 (R2.2), RN3.20 (R1.2), U6.2 (VCC); also elsewhere on the board
+5V: RN3.18 (R3.2); also elsewhere on the board
GND: C19.1, J8.2, RN3.11 (R10.2), RN3.12 (R9.2), RN3.13 (R8.2), U6.5 (GND), U6.6 (GND), U6.7 (GND), U6.8 (GND), U6.9 (GND), U6.10 (GND), U6.11 (GND), U6.12 (GND), U6.13 (GND); also elsewhere on the board
MCU-SCL: RN3.1 (R1.1), U6.16 (SCL); also elsewhere on the board
MCU-SDA: RN3.2 (R2.1), U6.15 (SDA); also elsewhere on the board
unnamed: J8.1, U6.14 (VBAT)
RS232_DRIVER_ON_OFF: RN3.8 (R8.1); also elsewhere on the board
RTC_~INT~_SQW: RN3.3 (R3.1), U6.3 (~INT~/SQW); also elsewhere on the board
VcR1: RN3.10 (R10.1); also elsewhere on the board
uSD_ON_OFF: RN3.9 (R9.1); also elsewhere on the board
