pedrolpena/datapod/schematics/datapod/datapod.kicad_pcb

## KiCad design schematics/datapod/datapod.kicad_pcb (continued)

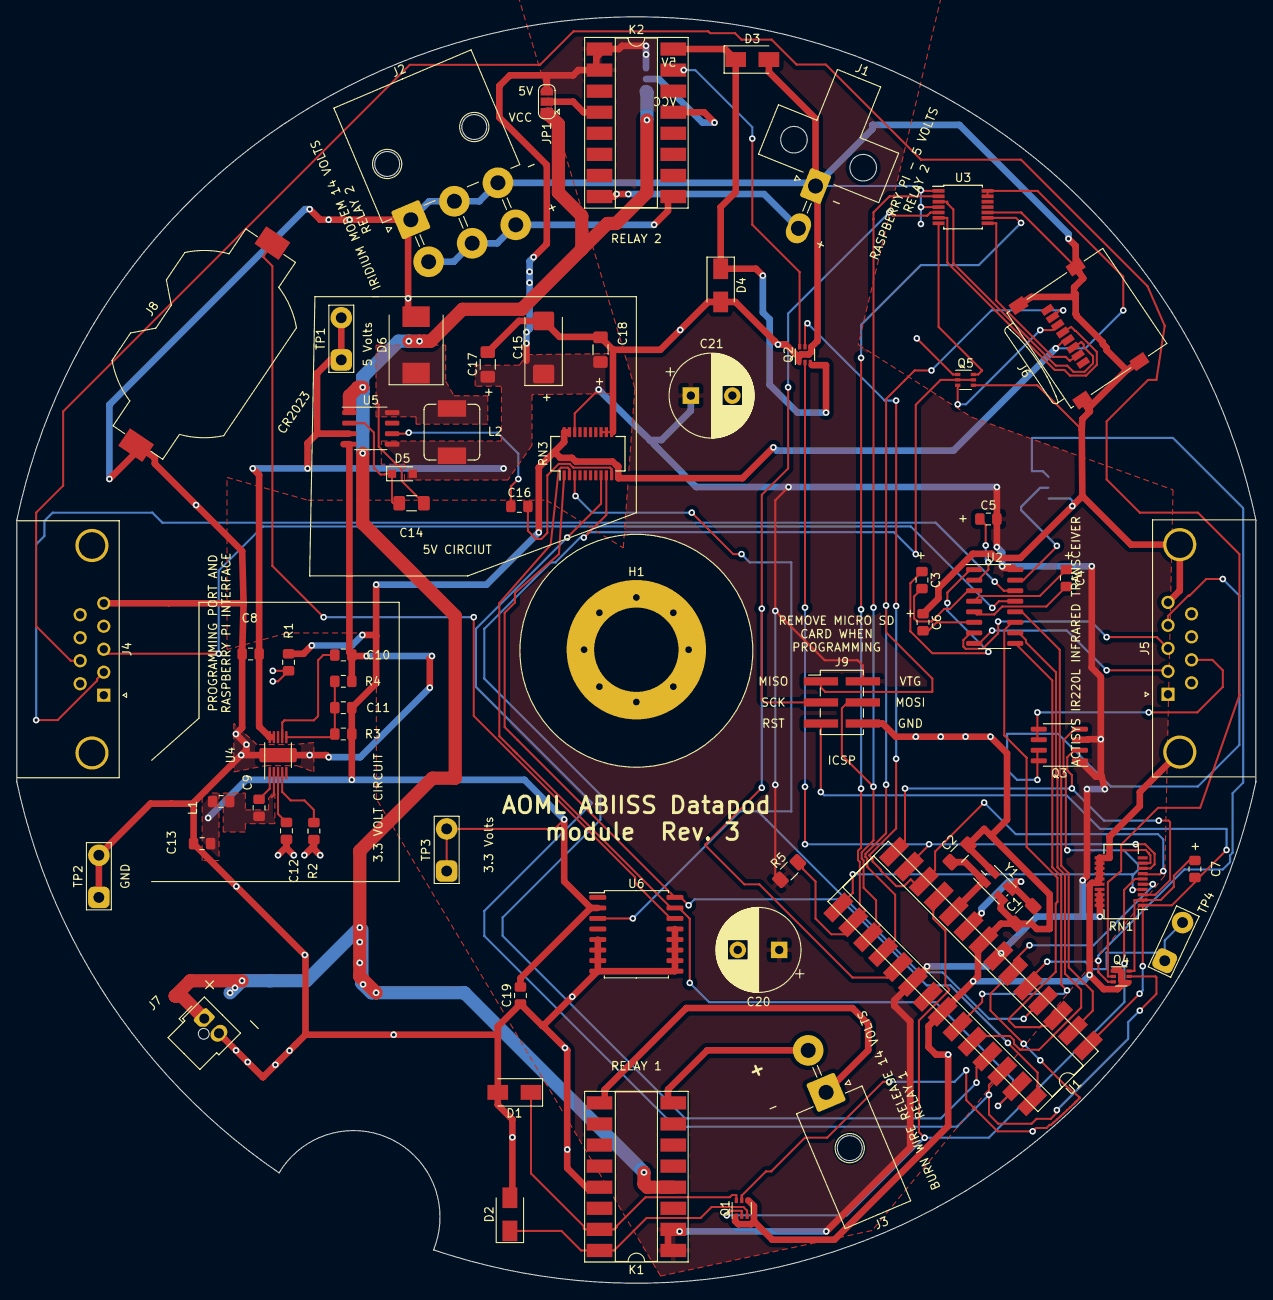
[picture p29: board datapod.kicad_pcb from above]

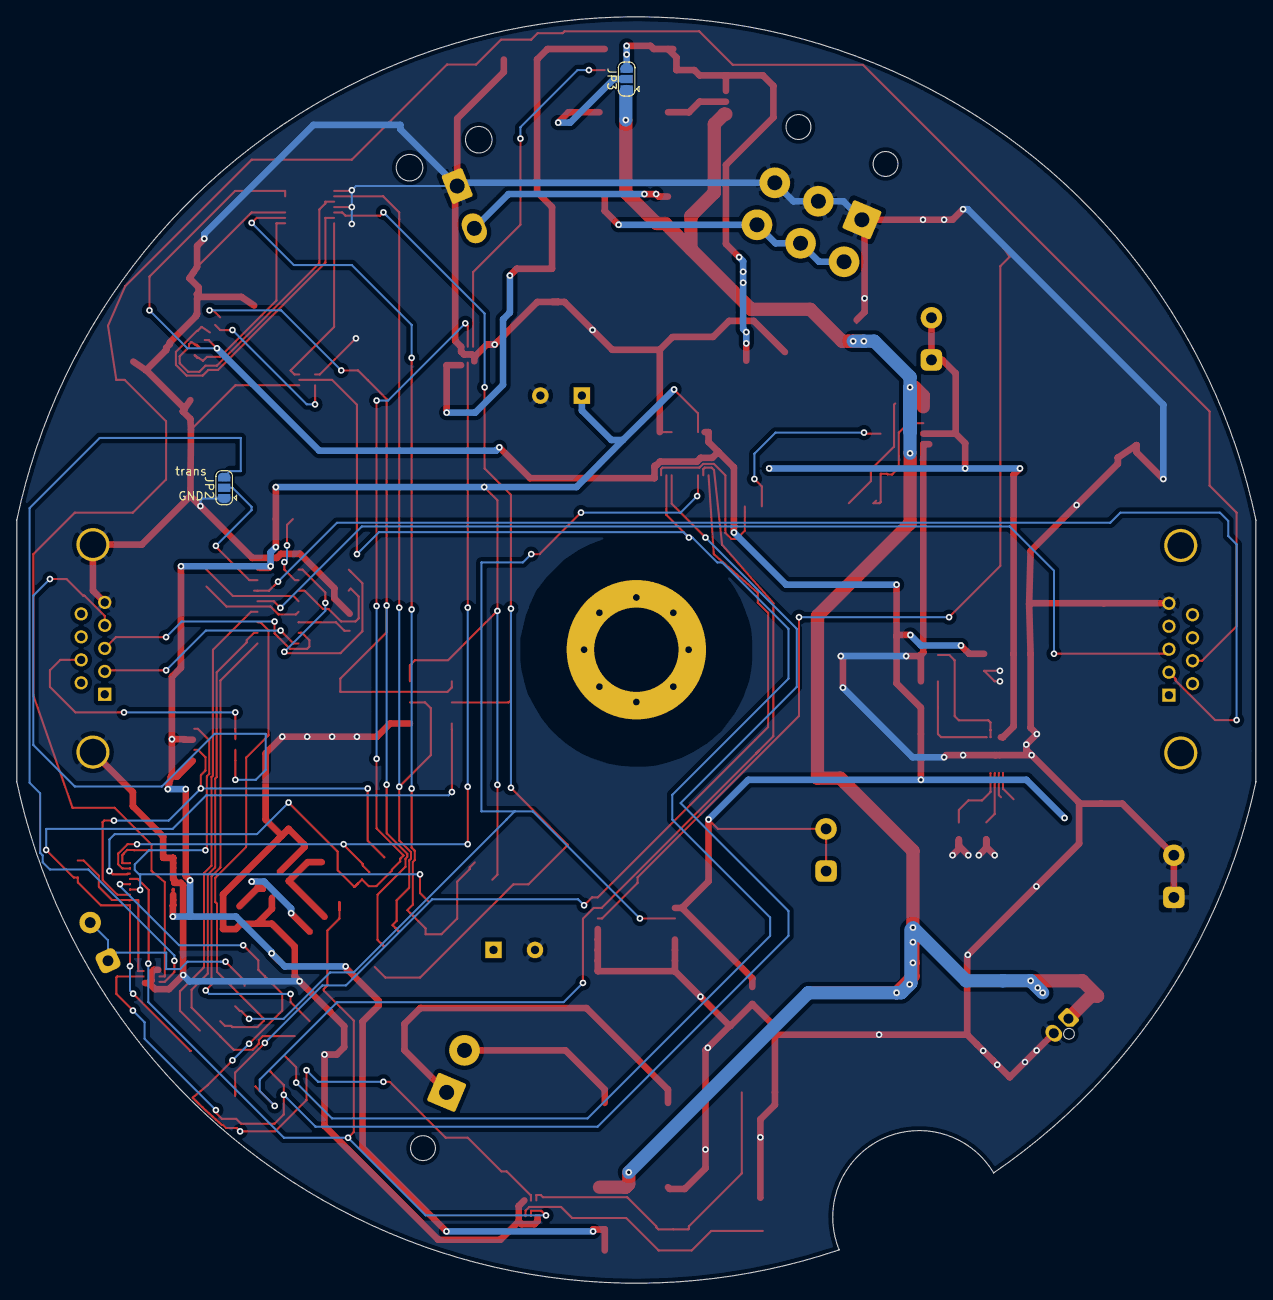
[picture p30: board datapod.kicad_pcb from below]

Board: 2 copper layers, 149.3 x 152.6 mm, 67 parts (2 on the bottom side), 69 nets.
