pedrolpena/datapod/schematics/datapod_IR_splitter/datapod_IR_splitter.kicad_pcb

## KiCad design schematics/datapod_IR_splitter/datapod_IR_splitter.kicad_pcb (2020-01-20)

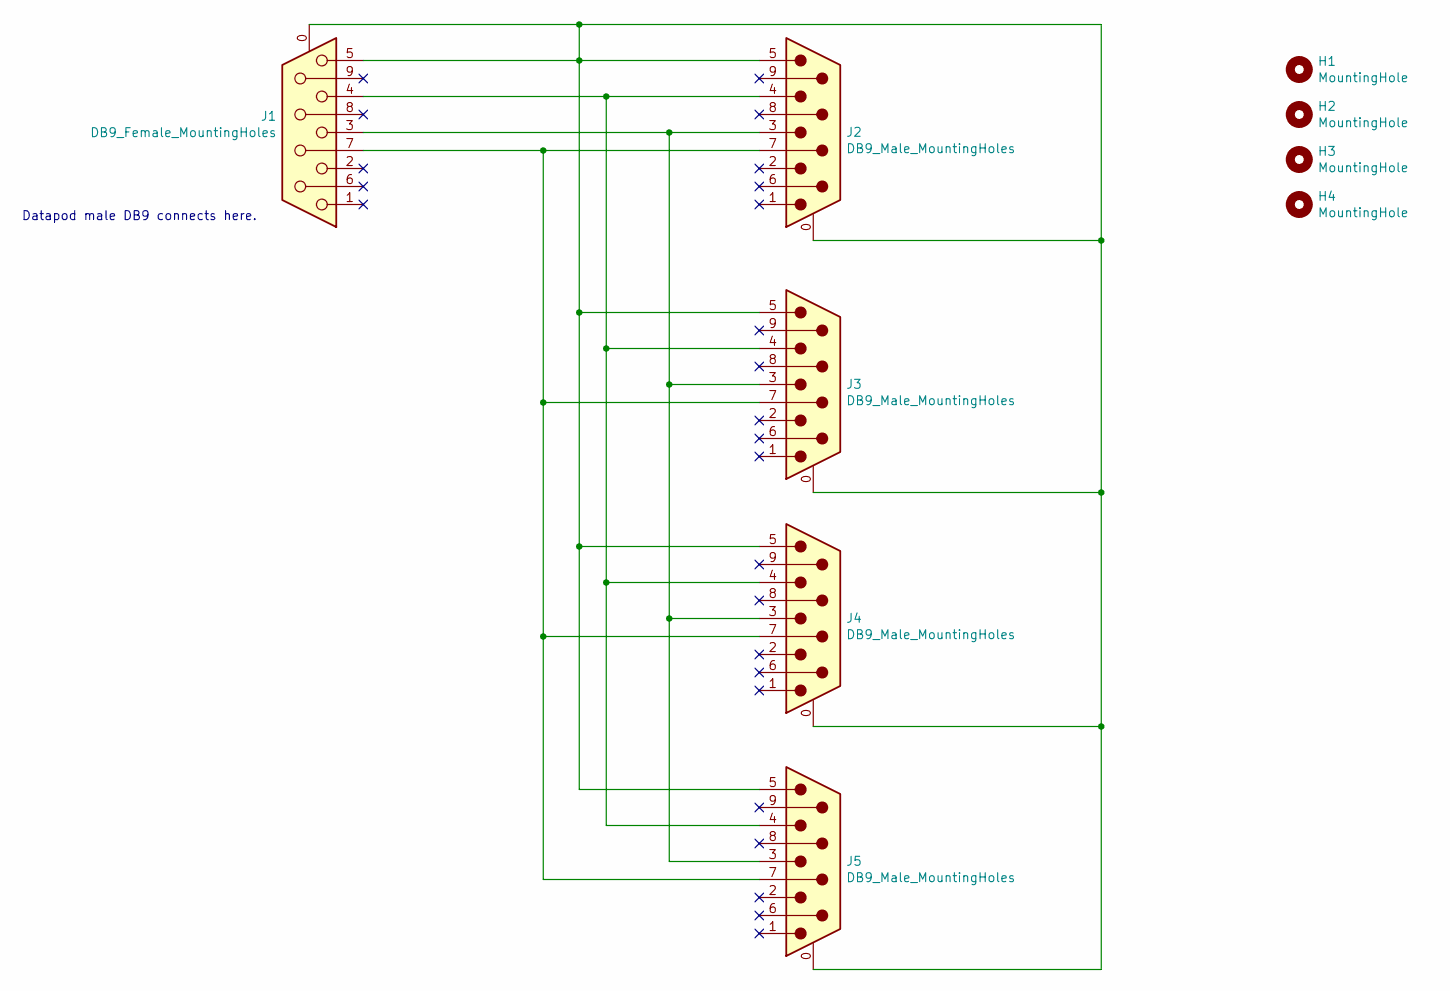
[picture p31: schematic datapod_IR_splitter.sch, Datapod IR splitter]

Parts:
H1, H2, H3, H4: MountingHole; MountingHole_4.5mm_Pad
J1: DB9_Female_MountingHoles; DSUB-9_Female_Horizontal_P2.77x2.84mm_EdgePinOffset9.90mm_H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; Part# AE10921-ND
J2, J3, J4, J5: DB9_Male_MountingHoles; DSUB-9_Male_Vertical_P2.77x2.84mm_MountingHoles; Part# 609-5184-ND

Connections:
unnamed: J1.0 (PAD), J1.5, J2.0 (PAD), J2.5, J3.0 (PAD), J3.5, J4.0 (PAD), J4.5, J5.0 (PAD), J5.5
unnamed: J1.3, J2.3, J3.3, J4.3, J5.3
unnamed: J1.4, J2.4, J3.4, J4.4, J5.4
unnamed: J1.7, J2.7, J3.7, J4.7, J5.7

Notes on the sheet:
Datapod male DB9 connects here.

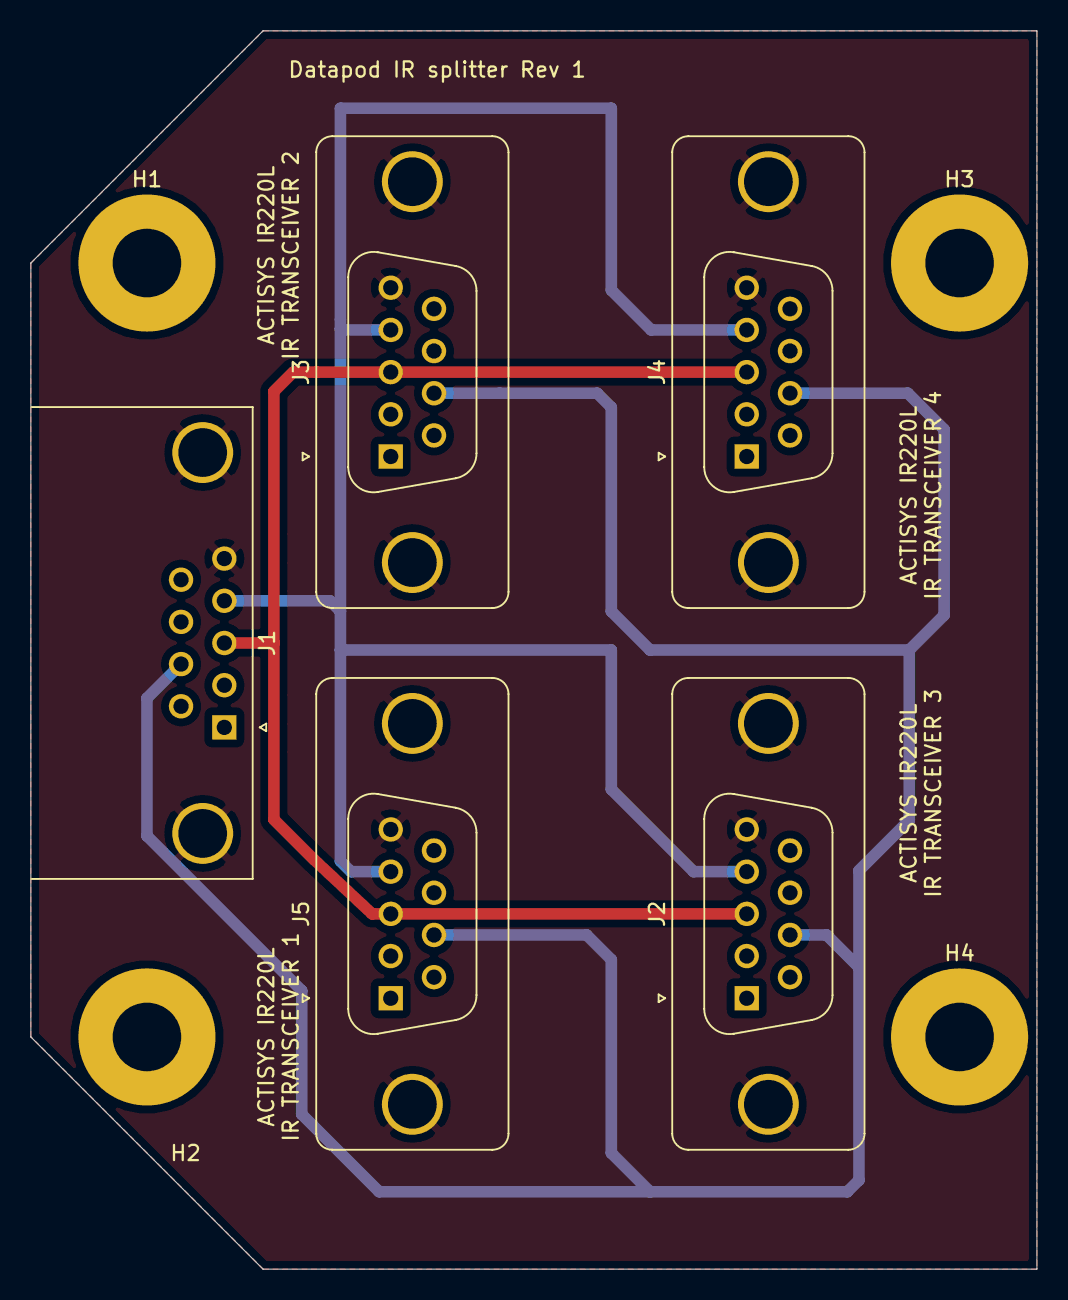
[picture p32: board datapod_IR_splitter.kicad_pcb from above]

Board: 2 copper layers, 66.0 x 81.3 mm, 9 parts (0 on the bottom side), 4 nets.
