pedrolpena/datapod/schematics/data_pod_battery_board/data_pod_battery_board.kicad_pcb

## KiCad design schematics/data_pod_battery_board/data_pod_battery_board.kicad_pcb (2019-12-12)

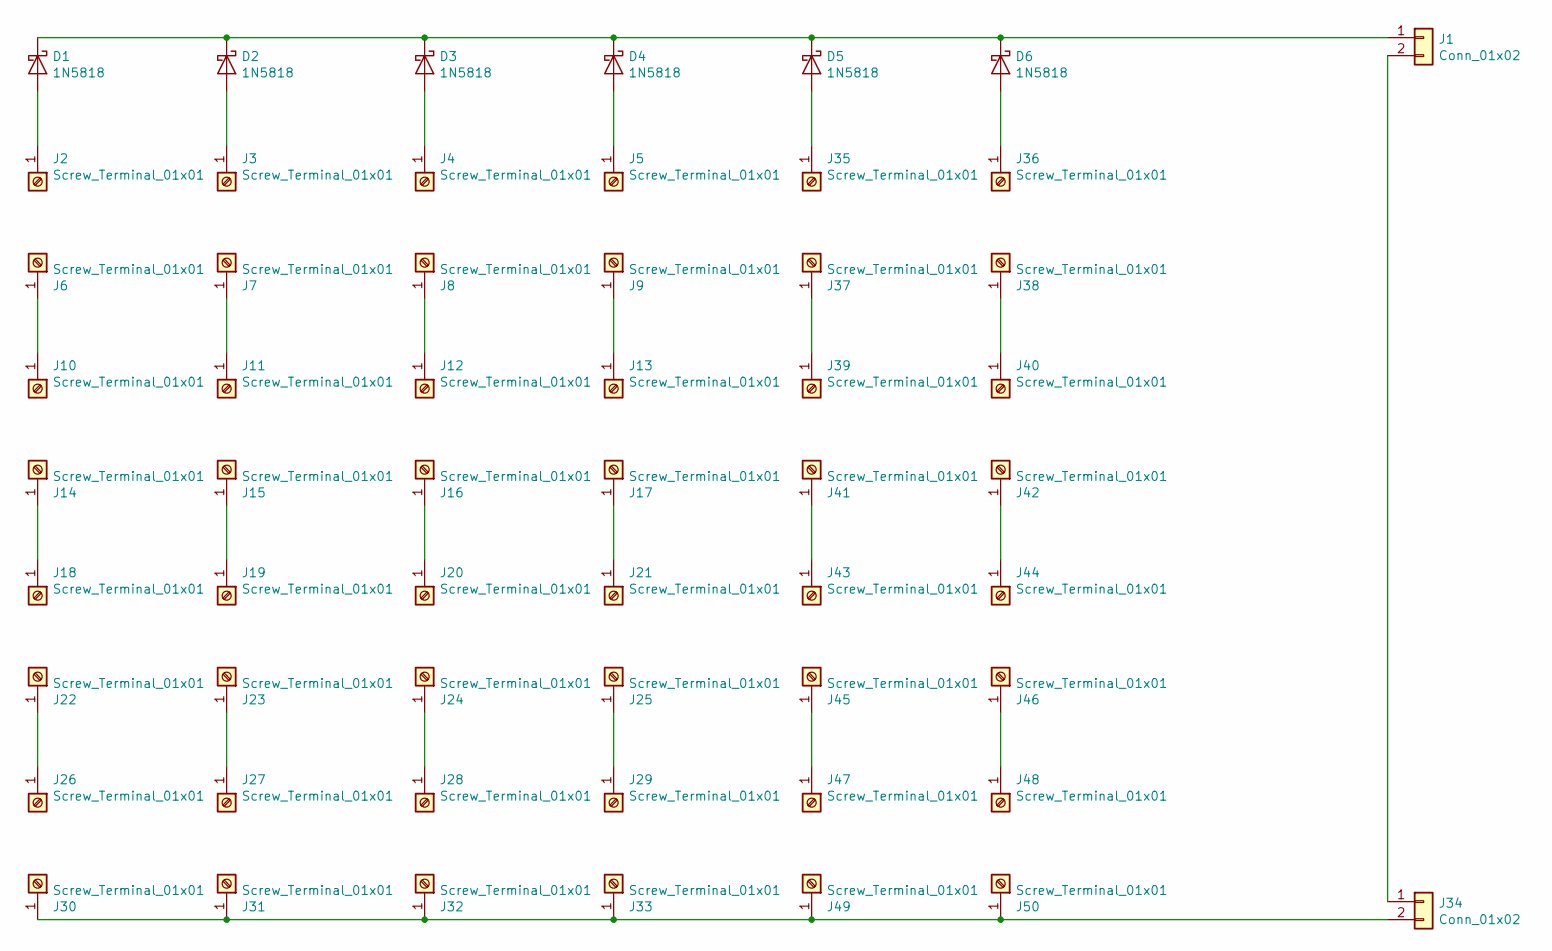
[picture p33: schematic data_pod_battery_board.sch, Data Pod Battery Board]

Parts:
D1, D2, D3, D4, D5, D6: 1N5818; D_DO-41_SOD81_P10.16mm_Horizontal; Part# 1N5818-TPCT-ND
J1, J34: Conn_01x02; Molex_Nano-Fit_105309-xx02_1x02_P2.50mm_Vertical; Part# WM15036-ND
J2, J3, J4, J5, J6, J7, J8, J9, J10, J11, J12, J13, J14, J15, J16, J17, J18, J19, J20, J21, J22, J23, J24, J25, J26, J27, J28, J29, J30, J31, J32, J33, J35, J36, J37, J38, J39, J40, J41, J42, J43, J44, J45, J46, J47, J48, J49, J50: Screw_Terminal_01x01; screw_terminal_7.0mmx5.0mm; Part# 36-7691-ND

Connections:
unnamed: D1.1 (K), D2.1 (K), D3.1 (K), D4.1 (K), D5.1 (K), D6.1 (K), J1.1
unnamed: D1.2 (A), J2.1
unnamed: D2.2 (A), J3.1
unnamed: D3.2 (A), J4.1
unnamed: D4.2 (A), J5.1
unnamed: D5.2 (A), J35.1
unnamed: D6.2 (A), J36.1
unnamed: J1.2, J34.1
unnamed: J6.1, J10.1
unnamed: J7.1, J11.1
unnamed: J8.1, J12.1
unnamed: J9.1, J13.1
unnamed: J14.1, J18.1
unnamed: J15.1, J19.1
unnamed: J16.1, J20.1
unnamed: J17.1, J21.1
unnamed: J22.1, J26.1
unnamed: J23.1, J27.1
unnamed: J24.1, J28.1
unnamed: J25.1, J29.1
unnamed: J30.1, J31.1, J32.1, J33.1, J34.2, J49.1, J50.1
unnamed: J37.1, J39.1
unnamed: J38.1, J40.1
unnamed: J41.1, J43.1
unnamed: J42.1, J44.1
unnamed: J45.1, J47.1
unnamed: J46.1, J48.1

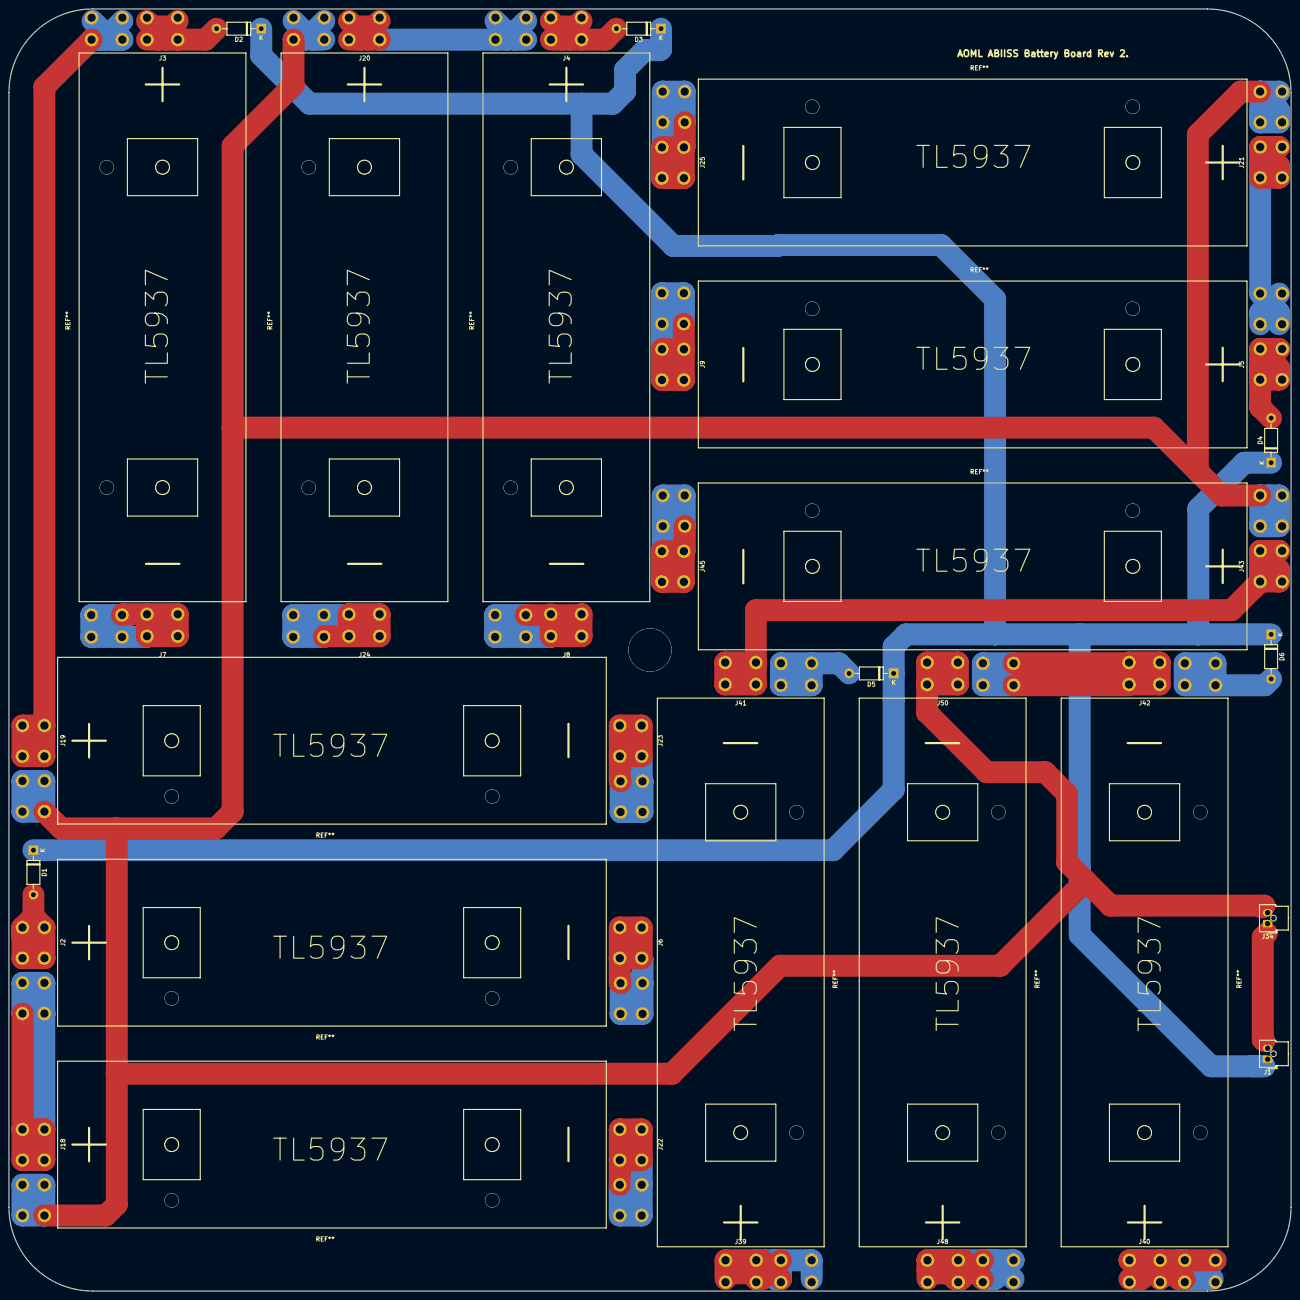
[picture p34: board data_pod_battery_board.kicad_pcb from above]

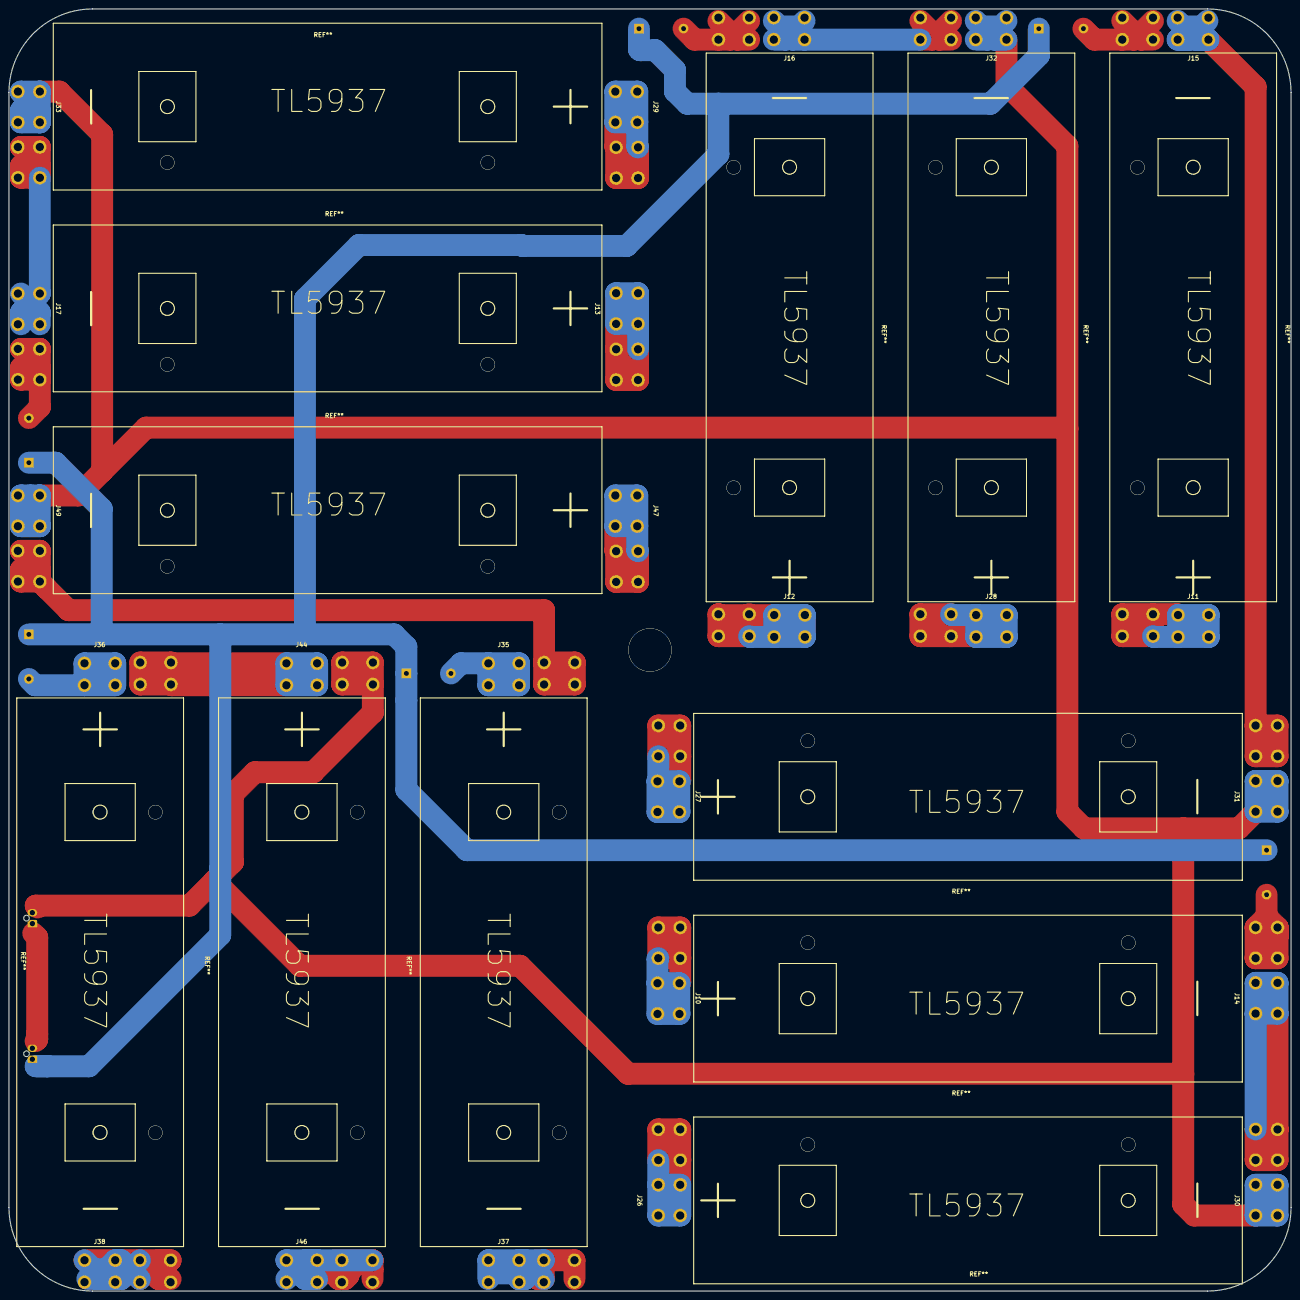
[picture p35: board data_pod_battery_board.kicad_pcb from below]

Board: 2 copper layers, 292.1 x 292.1 mm, 56 parts (24 on the bottom side), 27 nets.
