pedrolpena/datapod/(commit log)

2019-11-04 Added schematic for datapod
    [datapod.kicad_pcb, datapod.sch, datapod_5v_power.sch, datapod_power.sch, datapod_power_3v3.sch, datapod_relays.sch, datapod_rtc.sch, datapod_serial.sch]
2019-11-04 modified schematic
    [datapod_5v_power.sch, datapod_power_3v3.sch, datapod_relays.sch]
2019-11-05 added more connectors and started drawing the PCB
    [datapod.sch, datapod_5v_power.sch, datapod_power_3v3.sch, datapod_relays.sch, datapod_rtc.sch, datapod_serial.sch, datapods_sdcard.sch]
2019-11-05 made 1st pcb
    [datapod.dsn, datapod.kicad_pcb, datapod.sch, datapod_rtc.sch]
2019-11-06 finished routing now removing warnings
    [datapod.kicad_pcb, datapod_last.dsn]
2019-11-06 added final routed PCB, gerbers and BOM
    [datapod-B_CrtYd.gbr, datapod-B_Cu.gbr, datapod-B_Fab.gbr, datapod-B_Mask.gbr, datapod-B_SilkS.gbr, datapod-Cmts_User.gbr, datapod-Dwgs_User.gbr, datapod-Edge_Cuts.gbr]
2019-11-06 refreshed gerber/drill file and added 3d step files
    [039291028.stp, 110-xx-316-41-105000.stp, 110-xx-328-41-105000.stp, 428192214.stp, 693072010801.stp, 768250002.stp, 768250006.stp, LD09P24A4GV00LF .stp]
2019-11-07 added some more 3d models
    [CR2032-50004LC.stp, Crystal ABM3-16.000MHZ-B2-T.stp, datapod.kicad_pcb, uSD_card.STEP]
2019-11-08 added initial schematic for the battery board
    [data_pod_battery_board.kicad_pcb, data_pod_battery_board.sch, datapod.kicad_pcb]
2019-11-08 created footprint for terminal
    [data_pod_battery_board.sch]
2019-11-08 improved pcb outline
    [data_pod_battery_board.kicad_pcb, datapod.csv, datapod_relays.sch]
2019-11-12 improved layout a little
    [data_pod_battery_board.kicad_pcb]
2019-11-13 made some more changes to pcb
    [data_pod_battery_board.kicad_pcb, data_pod_battery_board.sch]
2019-11-15 added more changes
    [data_pod_battery_board.kicad_pcb, data_pod_battery_board.sch]
2019-11-18 finished battery baord pcb
    [1053091302.stp, data_pod_battery_board.kicad_pcb]
2019-11-18 added gerbers
    [data_pod_battery_board-B_Cu.gbr, data_pod_battery_board-B_Mask.gbr, data_pod_battery_board-B_Paste.gbr, data_pod_battery_board-B_SilkS.gbr, data_pod_battery_board-Edge_Cuts.gbr, data_pod_battery_board-F_Cu.gbr, data_pod_battery_board-F_Mask.gbr, data_pod_battery_board-F_Paste.gbr]
2019-11-20 final rev1
    [data_pod_battery_board-B_Cu.gbr, data_pod_battery_board-B_Mask.gbr, data_pod_battery_board-B_Paste.gbr, data_pod_battery_board-B_SilkS.gbr, data_pod_battery_board-Edge_Cuts.gbr, data_pod_battery_board-F_Cu.gbr, data_pod_battery_board-F_Mask.gbr, data_pod_battery_board-F_Paste.gbr]
2019-11-25 replaced rn2 with 4 resistors and moved sd card closer to mcu
    [datapod_5v_power.sch, datapod_power_3v3.sch, datapod_relays.sch, datapod_rtc.sch, datapod_serial.sch, datapods_sdcard.sch]
2019-12-01 added 3d models that somehow were lost.
    [datapod_serial.sch]
2019-12-12 increased the hole diameter for the terminal holes to 1.875 from 1.6
    [data_pod_battery_board.kicad_pcb]
2019-12-12 added gerber files for battery board
    [data_pod_battery_board-B_Cu.gbr, data_pod_battery_board-B_Mask.gbr, data_pod_battery_board-B_Paste.gbr, data_pod_battery_board-B_SilkS.gbr, data_pod_battery_board-Edge_Cuts.gbr, data_pod_battery_board-F_Cu.gbr, data_pod_battery_board-F_Mask.gbr, data_pod_battery_board-F_Paste.gbr]
2019-12-12 added text the pcb rev2
    [data_pod_battery_board-B_Cu.gbr, data_pod_battery_board-B_Mask.gbr, data_pod_battery_board-B_Paste.gbr, data_pod_battery_board-B_SilkS.gbr, data_pod_battery_board-Edge_Cuts.gbr, data_pod_battery_board-F_Cu.gbr, data_pod_battery_board-F_Mask.gbr, data_pod_battery_board-F_Paste.gbr]
2020-01-09 restored lost changes... moving sd card reader and replacing rn2 with actual resistors
    [datapod.kicad_pcb, datapod.sch, datapod_5v_power.sch, datapod_power_3v3.sch, datapod_relays.sch, datapod_rtc.sch, datapod_serial.sch, datapods_sdcard.sch]
2020-01-12 fixed bad gnd trace on 3.3v circuit and added comments to the silkscreen
    [datapod.kicad_pcb, datapod.sch, datapod_5v_power.sch, datapod_power_3v3.sch, datapod_relays.sch, datapod_serial.sch, datapods_sdcard.sch]
2020-01-13 added a jumper to select between 5v and 14v for the raspberry pi
    [datapod.kicad_pcb, datapod_relays.sch, datapod_serial.sch]
2020-01-16 added rtc stuff , rotated db9s , added on/off transistors for max chip and sdcard
    [428202213.stp, D-Sub6180xx211821_female.stp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]
2020-01-17 added a fabrication file, updated gerbers to include fab masks, and updated R5 part number
    [datapod-B_Cu.gbr, datapod-B_Fab.gbr, datapod-B_Mask.gbr, datapod-B_Paste.gbr, datapod-B_SilkS.gbr, datapod-Edge_Cuts.gbr, datapod-F_Adhes.gbr, datapod-F_CrtYd.gbr]
2020-01-18 added datapod IR splitter board
    [datapod_IR_splitter-B_Cu.gbr, datapod_IR_splitter-B_Mask.gbr, datapod_IR_splitter-B_Paste.gbr, datapod_IR_splitter-B_SilkS.gbr, datapod_IR_splitter-Edge_Cuts.gbr, datapod_IR_splitter-F_Cu.gbr, datapod_IR_splitter-F_Mask.gbr, datapod_IR_splitter-F_Paste.gbr]
2020-01-20 increased distance between db9 connectors and added notes to transfer file with rx on the terminal
    [datapod_IR_splitter-B_Cu.gbr, datapod_IR_splitter-B_Mask.gbr, datapod_IR_splitter-B_Paste.gbr, datapod_IR_splitter-B_SilkS.gbr, datapod_IR_splitter-Edge_Cuts.gbr, datapod_IR_splitter-F_Cu.gbr, datapod_IR_splitter-F_Mask.gbr, datapod_IR_splitter-F_Paste.gbr]
2020-01-27 updated code to reflect pcb change and added interrupt to code
2020-01-30 added a reference marker to C7 to know its orientation when installing
    [datapod.kicad_pcb]
2020-02-04 rev 3 , moved db9 connectors out and added ajumper to change output to 14.4v
    [datapod-B_Adhes.gbr, datapod-B_CrtYd.gbr, datapod-B_Cu.gbr, datapod-B_Fab.gbr, datapod-B_Mask.gbr, datapod-B_Paste.gbr, datapod-B_SilkS.gbr, datapod-Eco1_User.gbr]
2020-02-05 added two capacitors
    [datapod-B_Adhes.gbr, datapod-B_CrtYd.gbr, datapod-B_Cu.gbr, datapod-B_Fab.gbr, datapod-B_Mask.gbr, datapod-B_Paste.gbr, datapod-B_SilkS.gbr, datapod-Eco1_User.gbr]
2020-02-13 added a3la converter board
    [039291028.stp, 1053091302.stp, 110-xx-316-41-105000.stp, 110-xx-328-41-105000.stp, 428192214.stp, 428202213.stp, 693072010801.stp, 768250002.stp]
